amnaahmad43200/cloud-connected-aqi-network/docs/THESIS_FYP_REPORT[Final].pdf

CLOUD CONNECTED AQI NETWORK FOR PAKISTAN

by

Amna Ahmad

Zujaja Ibrahim

Supervisor

Faraan Mahmood

Department of Electrical Engineering

Institute of Space Technology, Islamabad

July 2024

i

CLOUD CONNECTED AQI NETWORK FOR PAKISTAN

by

Amna Ahmad

Zujaja Ibrahim

Supervisor

Faraan Mahmood

APPROVAL BY BOARD OF EXAMINERS

_____________________ | _____________________
Supervisor | Co-Supervisor
____________________ | _____________________
Internal Examiner | External Examiner

ii

AUTHORS DECLARATION

I take full responsibility of the research work conducted during the thesis titled

“Cloud Connected AQI Network for Pakistan”.

I solemnly declare that the research and development work presented in the thesis is

done solemnly by me with no significant help from any other person; however, small help

wherever taken is duly acknowledged. I have also written the thesis by myself. Moreover, I

have not presented this thesis or any part of the thesis previously to any other degree

awarding institution within Pakistan or abroad.

I understand that the management of IST has a zero-tolerance policy towards

plagiarism. Therefore, I as an author of the above-mentioned thesis solemnly declare that no

portion of my thesis has been plagiarized and any material used in this Thesis does not

contain any literal citing (verbatim) of more than 70 words (total) even by giving a reference

unless I have obtained the written permission of the publisher to do so. Furthermore, the

work presented in the thesis is my own original work and I have positively cited the related

work of the other researchers by clearly differentiating my work from their relevant work.

I further understand that if I am found guilty of any form of plagiarism in my thesis

work even after my graduation, the institute reserves the right to revoke my BS degree.

Moreover, the Institute will also have the right to publish my name on its website that keeps

a record of the students who plagiarized in their thesis work.

_____________________

Amna Ahmad

iii

Zujaja Ibrahim

I hereby acknowledge that submitted thesis is final version and should be scrutinized

for plagiarism as per IST policy

_____________________

Faraan Mahmood

Dated: _______________

________________________________

Verified by Plagiarism Cell Officer

Dated_______________

iv

CERTIFICATE

This is to certify that the research work described in this thesis is the original work of

the author and has been carried out under my direct supervision. I have personally gone

through all the data/results/materials reported in the manuscript and certify their

correctness/authenticity. I further certify that the material included in this thesis is not

plagiarized and has not been used in part or full in a manuscript already submitted or in the

process of submission in partial/complete fulfillment of the award of any other degree from

any institution. I also certify that the thesis has been prepared under my supervision

according to the prescribed format and I endorse its evaluation for the award of Bachelor of

Science in Electrical Engineering degree through the official procedures of the Institute.

____________________

Faraan Mahmood

v

### Copyright © 2022

This document is jointly copyrighted by the authors and the Institute of Space

Technology (IST). Both authors and IST can use, publish or reproduce this document in any

form. Under the copyright law no part of this document can be reproduced by anyone, except

copyright holders, without the permission of authors.

vi

DEDICATION

This research work is dedicated to our beloved Parents and Teachers and Friends who

supported and motivated us in tough times and made us into what we are today.

vii

ABSTRACT

The escalating concerns over air quality, particularly in urban areas like Islamabad,

necessitate effective remote monitoring and alert systems. This document details the

development of a prototype network for monitoring the Air Quality Index (AQI) in Islamabad.

The project employs strategically placed nodes with calibrated sensors, transmitting real-time

data to a central server through the MQTT protocol and sending hourly SMS alerts to the user

in case of the absence of a Wi-Fi connection. The data obtained through this network was used

in predictive analysis using machine learning algorithms, including Linear Regression, Cat-

Boost Regressor, Random Forest and Gradient Boost Regressor. A comparative analysis was

conducted to determine the best-fit model for accurate AQI predictions.

viii

### 1.1.1.1 TABLE OF CONTENTS

ix

x

xi

xii

xiii

LIST OF FIGURES

xiv

Figure 17: SSD1306 displaying individual pollutant concentrations and the Final AQI

xv

xvi

xvii

xviii

xix

LIST OF ABBREVIATIONS AND SYMBOLS

AQI

PPM

AWS

MQTT

PM

PCB

CO

IoT

Air Quality Index

Parts Per Million

Amazon Web Services

Message Queuing Telemetry Transfer

Particle Matter

Printed Circuit Board

Carbon mono-Oxide

Internet of Things

1

### 2 CHAPTER 01

### 2.1 Introduction

In recent years, the escalating concerns surrounding air quality have become a focal

point of concern. Urban areas face several challenges in maintaining breathable and sustainable

atmospheres. Islamabad, the capital city of Pakistan, is no exception to this predicament, with

its ever-growing population and rapid urbanization intensifying the need for effective air

quality management.

This paper delves into an initiative undertaken to address the critical issue of air quality

in Islamabad. The project centers around the establishment of a Network for Monitoring

Atmospheric Parameters and Air Quality Index (AQI). Such a network provides real-time data

that not only assesses the prevailing atmospheric conditions but also facilitates informed

decision-making for future development.

The network employs strategically placed nodes equipped with calibrated sensors,

which monitor key atmospheric parameters and AQI metrics. These sensors transmit real-time

data to a central server through the MQTT protocol, ensuring continuous monitoring and

analysis. In the event of a Wi-Fi connection failure, the system sends hourly SMS alerts to

users, maintaining a consistent flow of information.

Furthermore, the data collected by the network is utilized for predictive analysis using

a variety of machine learning algorithms, including Linear Regression, CatBoost Regressor,

Random Forest, and Gradient Boost Regressor. This approach enables the development of

predictive models that can forecast future air quality trends. A comparative analysis was

2

conducted to determine the most accurate and reliable model for AQI prediction, thereby

enhancing the system's capability to provide actionable insights.

To support this initiative, an AWS database was used for three months of data

collection, ensuring reliable and scalable storage of the vast amount of data generated. For

visualization of AQI parameters, the Blynk IoT platform was employed, providing an intuitive

and user-friendly interface for real-time monitoring and analysis of air quality metrics.

The initiative represents a significant step towards leveraging technology for

environmental sustainability and public health in Islamabad and then for Pakistan.

### 2.2 Problem Statement

Air quality degradation is a growing concern worldwide, particularly in rapidly

urbanizing cities like Islamabad, Pakistan. The city's increasing population and industrial

activities have led to significant air pollution, posing severe health risks to residents and

challenging the sustainability of the urban environment. Despite the critical need for effective

air quality management, there is a lack of real-time monitoring systems that can provide

accurate and actionable data on changing AQI levels.

Existing air quality monitoring solutions often suffer from absence of Real time data

monitors, lack of AQI data for accuracy comparison, and inadequate predictive capabilities,

hindering timely interventions and informed decision-making. Consequently, there is an urgent

need for a comprehensive, real-time monitoring network that can assess air quality accurately

and facilitate timely measures to reduce pollution. Without such a system, the ability to protect

public health and manage environmental quality in Islamabad remains severely compromised.

3

### 2.3 Objective

Due to rapid increase in pollution, Islamabad is in dire need of a proper air quality

monitoring network. Thus, the goal of this project is to cover the process of setting up a

prototype for an air quality monitoring network. By providing timely and accurate information,

this project not only addresses the immediate challenges of air quality but also lays the

groundwork for accurate and informed decision-making.

### 2.4 Literature Survey

To gain a comprehensive understanding of the current state and advancements in the

field of real-time air quality monitoring and predictive analysis, it is essential to review

related works. Numerous research studies and projects have been conducted over the past

few years, focusing on the development and implementation of air quality monitoring

systems. These studies highlight the importance of real-time data collection, data

preprocessing, and the application of machine learning models for accurate air quality

predictions.

In 2019, Rawal presented a research paper titled "Air Quality Monitoring System,"

which leverages sensor networks to collect real-time data on pollutants. The system

integrates gas sensors, such as MQ135 and MQ7, to measure critical pollutants like carbon

monoxide (CO), nitrogen dioxide (NO2), and particulate matter (PM). By continuously

monitoring these parameters, the system ensures accurate and timely information for

decision-makers and the public. Rawal’s work emphasizes the importance of data

preprocessing, which involves cleaning and transforming the raw sensor data to enhance its

quality and usability. Additionally, the study highlights the role of machine learning models

in predicting air quality trends. By applying algorithms to the preprocessed data, the system

4

can forecast future air quality levels, enabling timely measures to be taken to protect public

health. This research underscores the potential of integrating sensor networks and machine

learning for effective air quality management.

Another significant contribution to the field is the research paper by Banerjee, Sikdar,

and Roy, titled "IoT-based Air Pollution Monitoring." This study focuses on enhancing

environmental awareness through the deployment of a network of sensors across urban areas

to collect pollutant data. The data is then transmitted to a central server for analysis. The

project emphasizes several key aspects, including real-time monitoring, data visualization,

and public access. Continuous data collection from the deployed sensors ensures up-to-date

information on air quality. The collected data is visualized to provide clear and

comprehensible information to users, aiding in better understanding and awareness.

Furthermore, the system ensures that air quality information is accessible to the public,

promoting transparency and informed decision-making. By integrating IoT technologies,

Banerjee et al. contribute to sustainable urban development. Their work demonstrates how

real-time monitoring and data visualization can be leveraged to inform policy decisions and

engage the public in environmental protection efforts.

The Islamabad Air Quality Index (AQI) website by IQAir is another noteworthy

example of real-time air quality monitoring. This platform provides a comprehensive range

of features, including real-time data validation, pollutant concentrations, health

recommendations, forecasts, historical data, and opportunities for citizen participation. Key

features of the IQAir AQI website include real-time data validation, ensuring the accuracy

and reliability of the data presented to users; providing detailed information on the levels of

various pollutants in the air; offering advice on how to mitigate health risks associated with

poor air quality; predicting future air quality trends to enable timely actions; allowing users

5

to analyze past air quality patterns; and encouraging public involvement in monitoring and

reporting air quality issues. Leveraging these insights, the IQAir platform empowers users

with accurate information and contributes to a healthier environment. The integration of real-

time monitoring with user-friendly interfaces and actionable recommendations exemplifies

the potential of technology in addressing air quality challenges.

These studies and projects provide valuable insights into the development and

implementation of real-time air quality monitoring systems. By examining the methodologies

and findings of these works, we can identify best practices and potential areas for

improvement in our own project. The integration of sensor networks, data preprocessing,

machine learning models, and IoT technologies has proven to be effective in enhancing air

quality monitoring and predictive analysis.

6

### 3 CHAPTER 02

### 3.1 Solution Statement

Addressing the challenges highlighted in the problem statement, our solution focuses

on developing a robust Network for Monitoring Atmospheric Parameters and Air Quality

Index (AQI) in Islamabad. This initiative aims to establish a comprehensive real-time

monitoring system that effectively assesses and manages air quality in urban environments.

The solution involves deploying strategically placed sensor nodes equipped with

calibrated sensors to measure key atmospheric parameters and pollutants such as carbon

monoxide (CO), nitrogen dioxide (NO2), particulate matter (PM), and others. These sensors

will continuously collect real-time data and the esp32 microcontroller will process the AQI

using the set international standards and a Rolling Average of 24 values which were hourly

collected throughout the day is implemented in the final AQI calculation. The AQI along

with the individual concentration of the pollutants is transmitted to a central server using the

MQTT protocol. In case of Wi-Fi connection failure, the system will still send hourly SMS

alerts to users, ensuring uninterrupted monitoring and timely responsiveness.

To enhance the domain and usability of our cloud connected AQI network, our

solution incorporates robust data preprocessing techniques and Time Series predictive

analysis. This includes cleaning and transforming raw sensor data to eliminate noise and

improve data quality. Machine learning algorithms, including Linear Regression, CatBoost

Regressor, Random Forest, and Gradient Boost Regressor, will be employed for predictive

analysis. This analytical approach enables the development of models capable of forecasting

7

future air quality trends, thereby facilitating proactive measures to reduce pollution and

protect public health.

Furthermore, to optimize energy usage and extend operational longevity, each sensor

node's battery is optimized. The ESP32 microcontroller, utilized in each node, enters sleep

mode after every hourly reading over a 24-hour period while it’s RTC memory keeps a

record of previous data. This power-saving strategy ensures that approximately 97.5% of the

battery life is conserved, enhancing sustainability and reducing operational costs.

The solution also leverages advanced data storage capabilities, utilizing an AWS

database for three months of data collection. For visualization and user interface, the Blynk

IoT platform is utilized, providing intuitive access to real-time AQI parameters and historical

trends. This user-friendly interface empowers stakeholders with actionable insights,

promoting informed decision-making and community engagement in environmental

management.

By integrating these components into a cohesive network, our solution aims to

contribute to sustainable urban development and improve air quality management practices

in Islamabad.

### 3.2 Individual Description of Equipment used in each node

### 3.2.1 ESP32

The ESP32 microcontroller was chosen for its flexibility and efficiency in IoT

applications. Its dual-core architecture, low power consumption, and built-in Wi-Fi

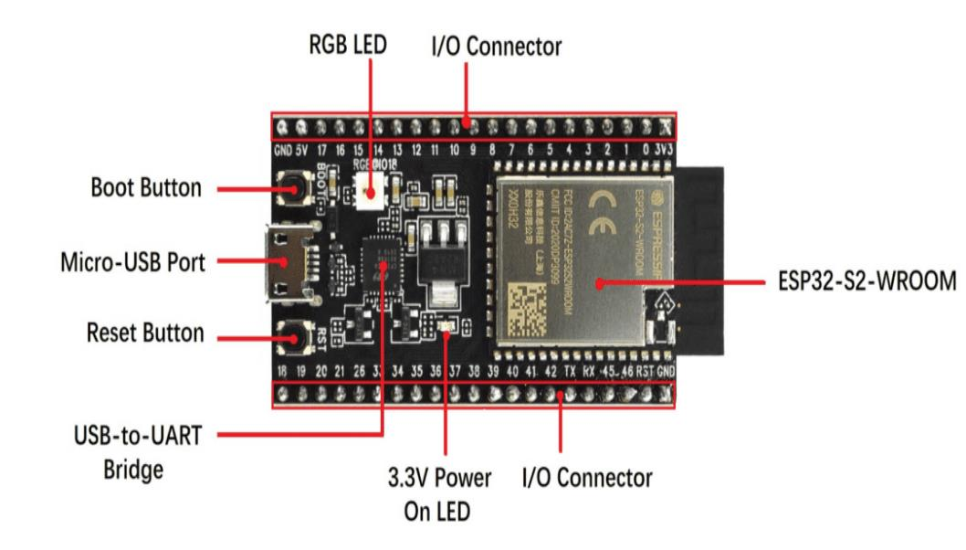
[picture p13: figure]

8

capabilities make it ideal for collecting, processing, and transmitting real-time air quality

data. Additionally, the ESP32's ability to enter sleep mode between hourly readings

maximizes battery life, crucial for prolonged field deployments without compromising data

reliability or operational lifespan.

Figure 1: ESP32 micro-controller

### 3.2.2 MQ7

The MQ7 sensor is commonly used for detecting carbon monoxide (CO) gas in the

atmosphere. It operates based on the principle of chemical reaction with CO, generating an

electrical signal proportional to the gas concentration. This sensor is valued for its sensitivity

and reliability in monitoring CO levels, making it suitable for applications in air quality

monitoring and safety systems.

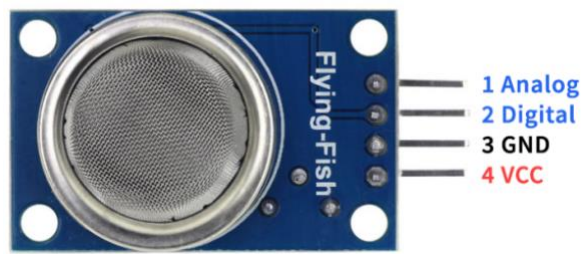
[picture p14: figure]
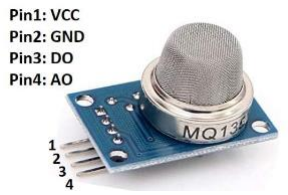
[picture p15: figure]

9

Figure 2: MQ7 Sensor pinout

### 3.2.3 MQ135

The MQ135 sensor detects sulfur dioxide (SO2) by utilizing a chemical reaction

mechanism. It operates by exposing a tin dioxide (SnO2) sensing element to the air

containing SO2. When SO2 molecules come into contact with the SnO2 surface, they

undergo a chemical reaction, changing the electrical conductivity of the sensor. This change

in conductivity is then converted into an electrical signal, which is proportional to the

concentration of SO2 in the air.

Due to its sensitivity to SO2, the MQ135 sensor is commonly used in environmental

monitoring applications, and indoor air quality assessments where monitoring SO2 levels is

critical for health and safety reasons.

Figure 3: MQ135 sensor pinout

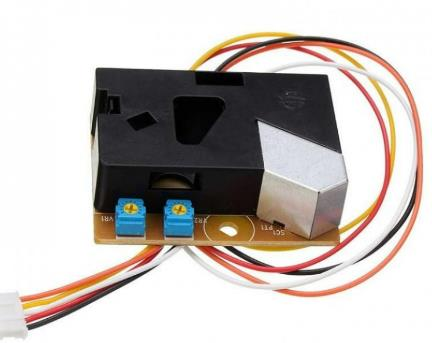
[picture p16: figure]

10

### 3.2.4 DSM501A

The DSM501A sensor is used for detecting fine particulate matter (PM2.5 and PM10)

in the air. It operates based on a principle involving light scattering by particles passing

through an LED and photodetector pair. As particles pass through the sensor, they scatter

light, and the intensity of scattered light detected by the photodetector correlates with the

concentration of particulate matter in the air.

This sensor is valued for its accuracy in measuring PM2.5 and PM10 levels, making

it suitable for applications in air quality monitoring systems, indoor air quality assessments,

and environmental monitoring. Its ability to provide real-time data on particulate pollution

helps in assessing health risks associated with fine particulate matter exposure.

Figure 4: DSM501A image

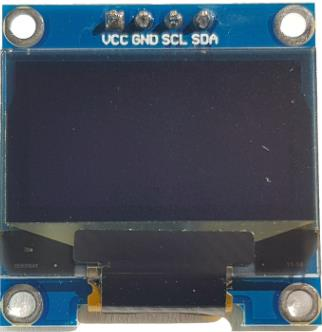
[picture p17: figure]

11

### 3.2.5 OLED

The following two types of OLEDs were utilized in this project to show the

versatility of display on hardware.

### 3.2.5.1 SSD1306 128x64

The SSD1306 128x32 OLED display is a small screen known for its clear and bright

display. It uses organic light-emitting diodes to show sharp text and graphics without needing

a backlight, making it great for small devices and projects where space and power are limited

which is the case in this prototype. It typically interfaces with microcontrollers using the I2C

communication protocol, allowing for easy and efficient data transfer.

Figure 5: SSD1306 image

### 3.2.5.2 TFT 128x160

The TFT 128x160 display is a thin-film transistor screen that offers bright colors and

high resolution. It provides clear and detailed images, making it suitable for applications that

need vibrant display (Creative and enlarged display of AQI). This display usually interfaces

with microcontrollers using the SPI communication protocol, ensuring fast and reliable data

communication.

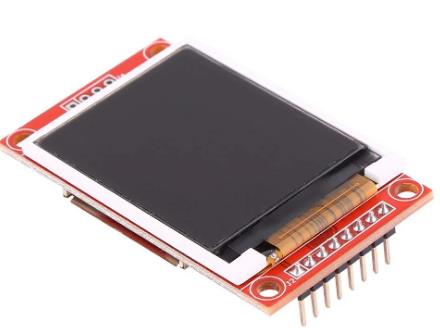
[picture p18: figure]
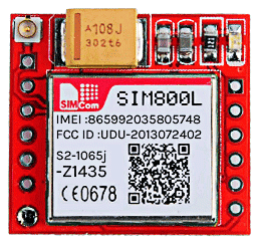
[picture p19: figure]

12

Figure 6: TFT 128X64 image

### 3.2.6 SIM800L

The SIM800L module is a compact GSM/GPRS module used for wireless

communication. It enables devices to send SMS alerts and make voice calls over the GSM

2G network. In this project, the SIM800L is utilized to send hourly SMS alerts so the user

stays aware of the AQI even when there is no Wi-Fi, ensuring continuous monitoring and

timely notifications. Its small size, low power consumption, and reliable connectivity make it

ideal for remote monitoring applications.

Figure 7: SIM800L image

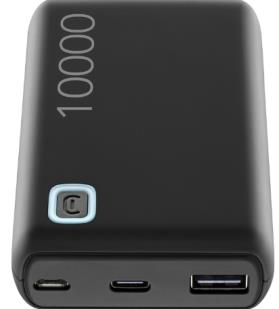
[picture p20: figure]

13

### 3.2.7 Power Source

A 5V 2A power bank is used to power the AQI node, providing a reliable and

portable power source. The power bank's 5V output is compatible with the node's

requirements, and its 2A current rating ensures stable and adequate power for all connected

components, enhancing the system's overall reliability and mobility.

Figure 8: 5V 2A Power bank

### 3.2.8 Micro USB cable

The cable is used to encode the esp32 and to connects the power bank to it, ensuring a

steady and reliable power supply. The cable supports the power needed by the AQI node,

helping to keep the system running smoothly and reliably in different settings.

Figure 9: Micro USB cable

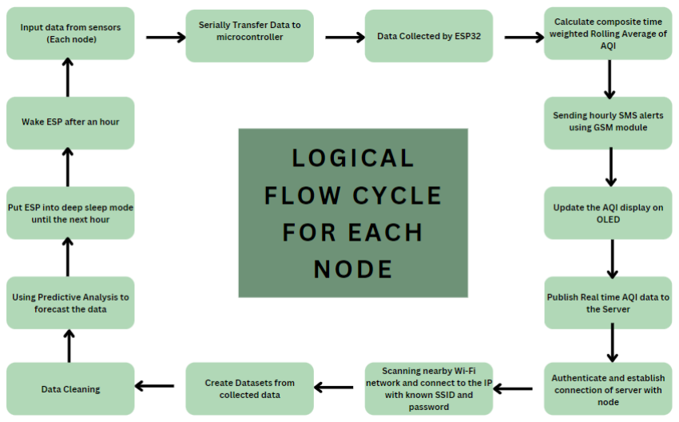
[picture p21: figure]

14

### 3.3 Block Diagram

The following flow diagram illustrates the logical working of a single node. The

block Diagram looks like a cycle which repeats because ESP32 repeats this process every

time after it wakes up from its deep sleep mode.

Figure 10: Block Diagram Illustration

15

### 4 CHAPTER 3: SYSTEM DETAILS

The individual node is comprised of the necessary sensors connected to the ESP32

microcontroller to measure the concentrations of the air pollutants in the air that are then

inserted into the formula for AQI which is then messaged to the user, displayed on node’s

OLED and uploaded on the cloud server Blynk in real time. The data collected was the stored

and further used for Predictive analysis using different machine learning models. This block

of the report will go into details about each process mentioned above

### 4.1 Sensors and their calibration:

The sensors attached to each node included 3 sensors which are connected to the ESP 32:

i. MQ 7: Measures the concentration of Carbon monoxide
ii. | MQ135: Measures the concentration of Sulfites
iii. | DSM501A: Measures the concentration of PM2.5 and PM1

### 4.1.1 Calibrating MQ-7:

The internal sensor resistance (RS) is calculated using the formula:

where VC is the circuit voltage, RL is the load resistance, and VRL is the voltage across

the load resistor.

RS = (

VC−VRL
VRL
)−RL | (1)

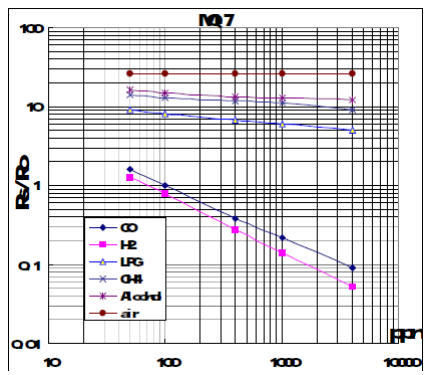
[picture p22: figure]

16

Figure 11: Sensitivity characteristics of MQ7

From the graph, the resistance ratio (RS/R0) in fresh air is observed to be a constant

value of 20.8. To find the reference resistance (R0), measure RS in clean air and use

the ratio:

Measure the analog voltage readings from the sensor. Convert these readings to

voltage values to determine RS using the formula provided. The graph (Fig. 3.1)

shows RS/R0 versus ppm for different gases. To calculate gas concentration, read the

graph whilst using a log-log scale.

The relationship is linearized using the formula:

RS/RO = 20.8 | (2)

log (

RS
RO) = m ∗ log(x) + b
(3)

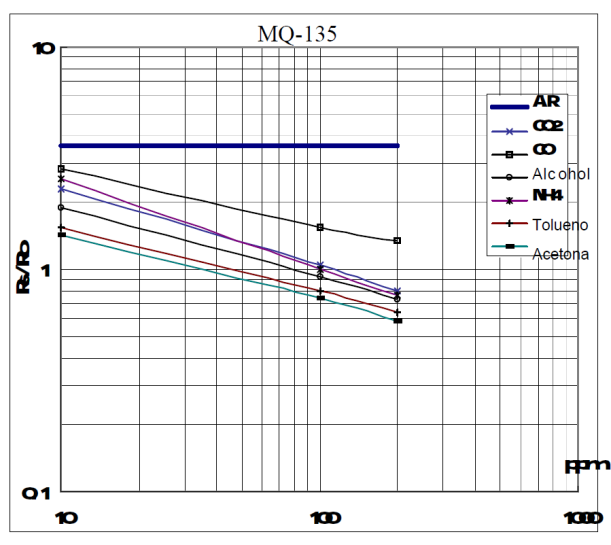
[picture p23: figure]

17

### 4.1.2 Calibrating MQ-135

The process of calibration for MQ135 follows the same steps as that for MQ7 with the

exception of the values from the sensitivity curve. Which is as follows:

Figure 12: Sensitivity characteristics of MQ135

### 4.1.3 Calibrating DSM501A

To take readings from the DSM501A sensor firstly we calculated the low ratio by

measuring the sum of low pulses received to the GPIO pins of the ESP32 for 30 seconds. The

value was then inserted into the equation provided to us in the sensor’s datasheet which is as

follows:

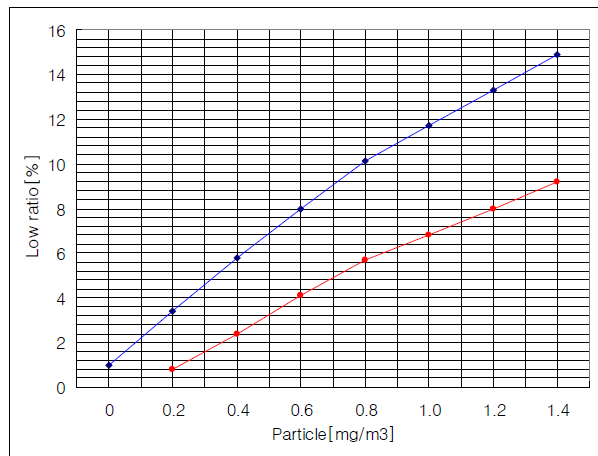
[picture p24: figure]

18

The calculated low ratio is then mapped across the sensor characteristic vs low ratio graph provided in the datasheet which is shown below:

Figure 13: Sensor characteristic vs Low ratio

Using the calculated low ratio percentage and the graphs we deduced the values of PM2.5

and PM1 in mg/m3 dividing each concentration by 1000 we converted our units to ug/m3

### 4.2 Calculating time weighted AQI

The pollutants used to calculate the AQI included CO, SO2, PM2.5 and PM1 Each

pollutant has specific concentration ranges, known as breakpoints, associated with

corresponding AQI value ranges that indicate different levels of health concern. To calculate

Low ratio[%] =

t(sec)
30(sec)
∗ 100 | (1)

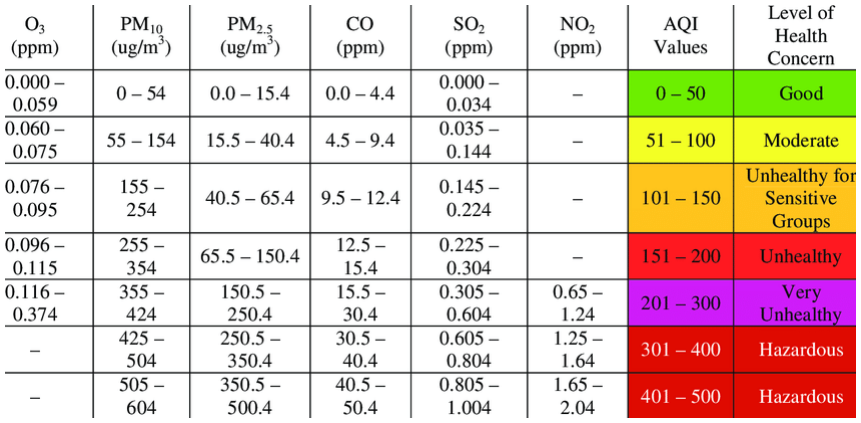
[picture p25: figure]

19

the AQI, the concentration of each pollutant is measured and its corresponding breakpoint

range is identified. A linear equation is then used to calculate the AQI for each pollutant:

where IH and IL are the AQI values at the upper and lower ends of the breakpoint

range, and CH and CL are the concentration breakpoints at the upper and lower ends of the

range, with C being the measured concentration. The breakpoint values are set using the

standard EPA’S breakpoint table for each pollutant.[2] (https://www.researchgate.net/figure/EPAs-breakpoint-and-AQI-Index_tbl1_315006128)

Figure 14: EPA's breakpoint and AQI Index [2]

In the process of calculating the composite time-weighted rolling average for AQI,

weights are assigned to data points of each pollutant based on their age, with recent data

points receiving higher weights through an exponential decay factor of 0.5. Subsequently, the

time-weighted rolling average for each pollutant is computed by multiplying each AQI data

AQI= (IH−IL)/(CH−CL)) ×(C−CL) +IL | (1)

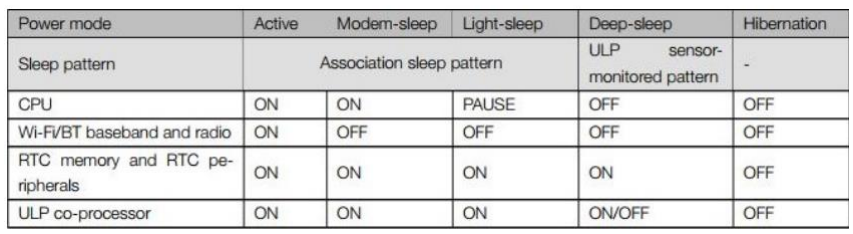
[picture p26: figure]

20

point by its respective time-based weight, summing these products, and then dividing by the

sum of the weights. Following this, composite weights are determined for each pollutant

based on their health impact and regulatory significance, representing their relative

importance in the overall air quality index. These composite weights are then used to

calculate the weighted rolling average for each pollutant. Finally, the weighted rolling

averages of all pollutants are summed to obtain the composite time-weighted rolling average

AQI, providing a unified measure that integrates the effects of all included pollutants and

reflects the overall air quality.[1] (https://forum.airnowtech.org/t/the-nowcast-for-pm2-5-and-pm10/172)

### 4.3 Using deep sleep mode of ESP32:

When our node wasn't sampling pollutant values, calculating AQI, or sending data to the

cloud server, it would enter sleep mode to conserve energy. This energy-saving feature is

crucial for extending the battery life of the device, especially in remote or off-grid locations.

Figure 15: Sleep Mode comparison chart [3]

The Real-Time Clock (RTC) of the microcontroller played a vital role by triggering the

ESP32 from sleep mode to active mode at scheduled intervals. Upon waking, the ESP32

would sample sensor values for various pollutants and store them in a circular queue. Circular

queues were chosen because they efficiently manage a fixed-size buffer, making them ideal

21

for continuously updating datasets like pollutant levels over time. A total of five circular

queues were created: one for SO₂ values, one for CO, one for PM2.5, one for PM1, and one

for AQI. These circular queues were stored in the RTC memory of the ESP32, which is non-

volatile, ensuring that all past 24-hour values were retained even when the controller was in

sleep mode. This setup allows for continuous monitoring and accurate calculation of AQI by

maintaining a rolling history of pollutant concentrations, ensuring data integrity and

reliability.

### 4.4 OLED display

An OLED display is attached to the node's casing to show the values of PM1 and PM2.5 in

µg/m³, SO₂ and CO in ppm, and the final calculated AQI every hour when the ESP32 is

triggered from sleep to active mode. This real-time display allows users to quickly and easily

monitor air quality data. We evaluated two display options: the SSD1306 and the TFT

128x160. The TFT 128x160 offered a larger and more vibrant display, enhancing readability

and providing more space for detailed information. However, it consumed significantly more

energy, which was a drawback for our battery-operated nodes designed for extended field

deployment. As a result, we opted for the SSD1306 for most of our nodes due to its lower

power consumption, compact size, and sufficient resolution for displaying all necessary

information clearly. This choice effectively balanced the need for energy efficiency with the

requirement for a functional and user-friendly interface.

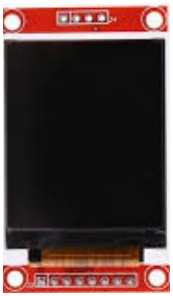
[picture p27: figure]
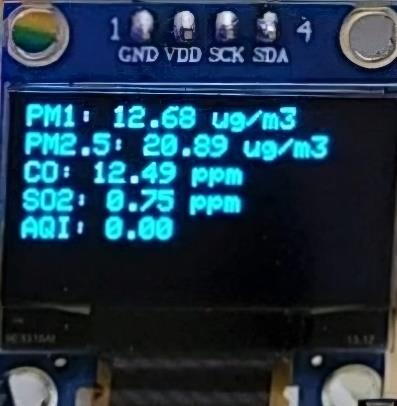
[picture p28: figure]

22

Figure 16: TFT display

Figure 17: SSD1306 displaying individual pollutant concentrations and the Final AQI

### 4.5 Sending SMS alerts to users

Using the GSM SIM800L module, we sent hourly updates to our users about air

pollutant concentrations. These updates included the values of PM1 and PM2.5 in µg/m³,

SO₂ and CO in ppm, and the calculated AQI. The ESP32 would wake from sleep mode every

hour to collect the latest data and transmit it in real-time, ensuring users received up-to-date

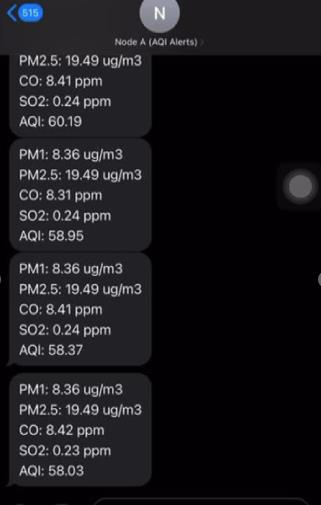
[picture p29: figure]

23

information about air quality at the specific geolocation where the node was placed. This

system provided users with critical information to help them make informed decisions about

their environment. The SIM800L module was chosen for its reliable GSM connectivity and

low power consumption, making it suitable for our remote monitoring needs. Only selected

phone numbers that were pre-programmed into the code would receive these notifications,

ensuring that the updates were sent exclusively to authorized users. This selective

notification system enhanced security and ensured that the information reached the right

recipients without unnecessary data transmission.

Figure 18: SMS Alerts received on user's phone

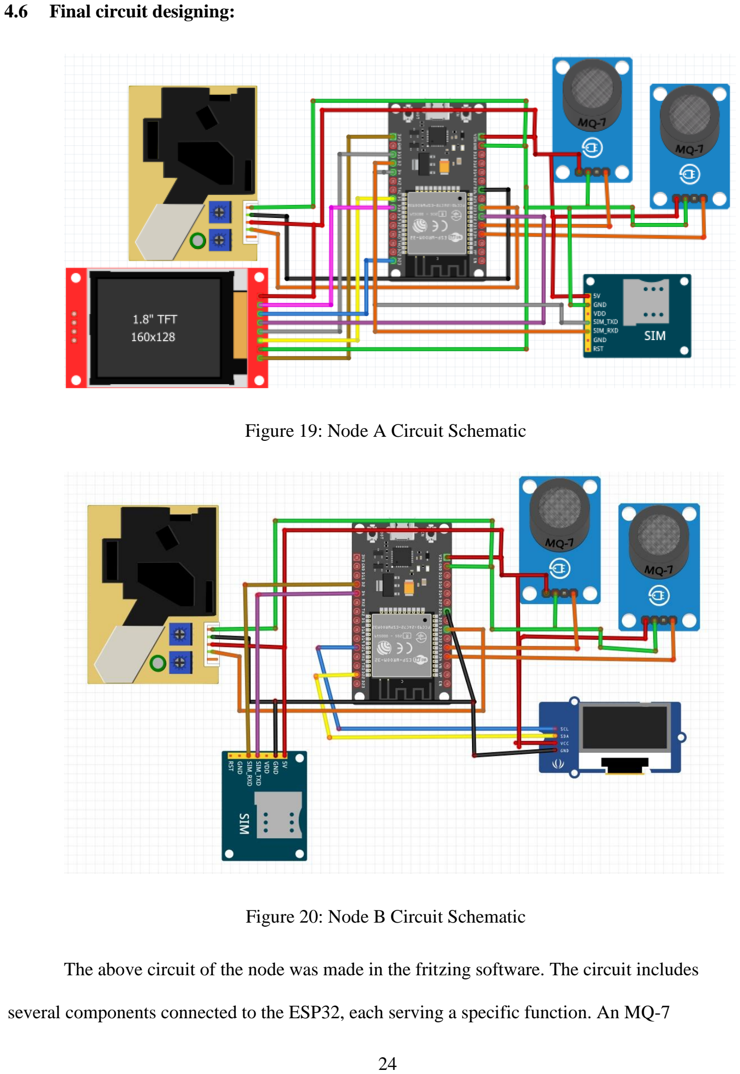
[picture p30: page 44]

24

### 4.6 Final circuit designing:

Figure 19: Node A Circuit Schematic

Figure 20: Node B Circuit Schematic

The above circuit of the node was made in the fritzing software. The circuit includes

several components connected to the ESP32, each serving a specific function. An MQ-7

25

sensor is used for measuring carbon monoxide (CO) levels, and an MQ-135 sensor is used

for measuring sulfur dioxide (SO₂) levels. A DSM501A sensor is included to measure

particulate matter levels (PM2.5 and PM1). The SIM800L GSM module is integrated to send

hourly air quality updates via SMS to pre-programmed phone numbers. Additionally, a 1.8"

TFT 160x128 display is used for real-time visualization of pollutant concentrations and AQI.

The wiring diagram shows the connections between these components and the ESP32.

The red wires represent connections to the 5V supply of the ESP32, while the green wires

represent ground connections.

### 4.7 PCB designing:

Firstly, the design of our air quality monitoring node’s schematic was designed using

Proteus software. schematic diagram detailed the connections between the ESP32

microcontroller, MQ-7 sensors for CO detection, MQ-135 sensor for SO₂ detection,

DSM501A sensor for PM2.5 and PM1 detection, and the SIM800L GSM module for SMS

notifications. Female headers were used to place the sensors, OLED and sim module on top

of them to form stable connections with the ESP32 board.

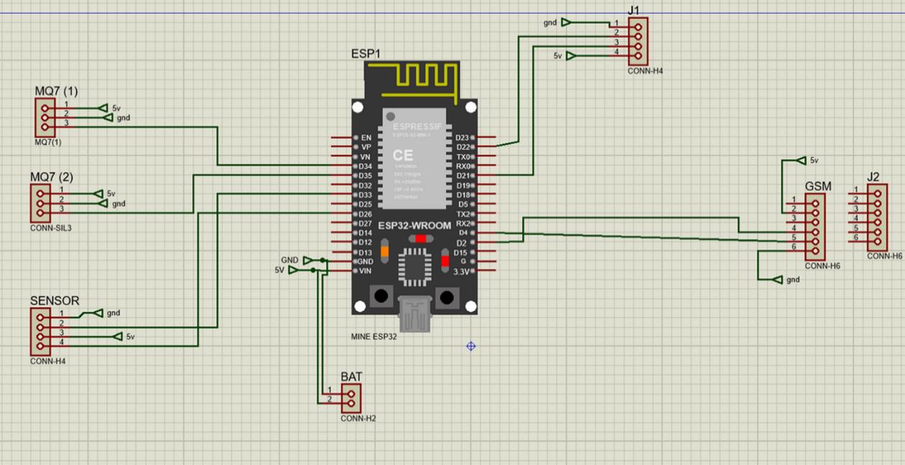
[picture p31: figure]

26

Figure 21: Circuit Design of node in proteus

Secondly, the PCB layout was generated in Proteus, highlighting the routing

connections to ensure no interference between unwanted connections. The PCB design

composes the components onto a compact board, facilitating easy assembly and deployment

of the monitoring node.

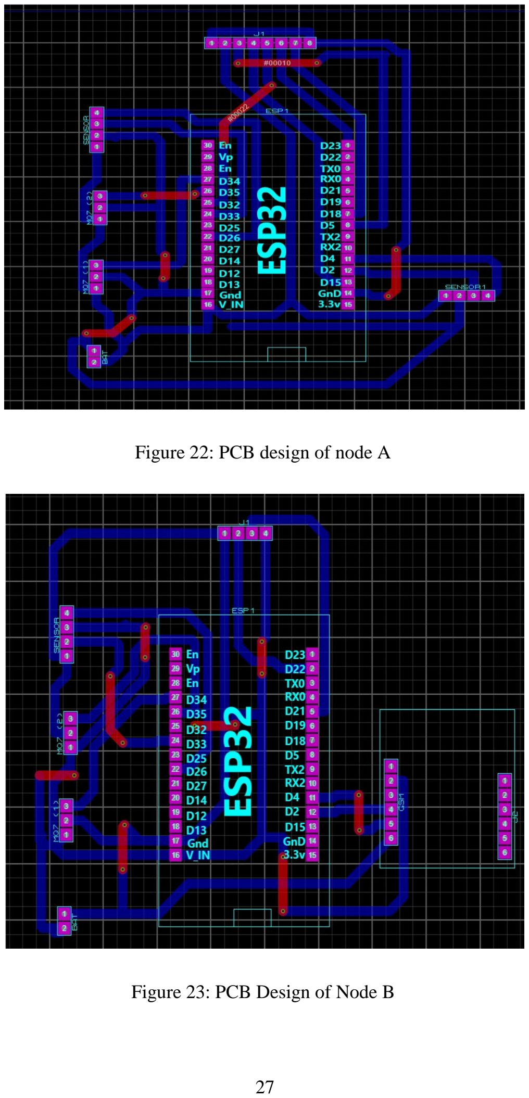
[picture p32: page 47]

27

Figure 22: PCB design of node A

Figure 23: PCB Design of Node B

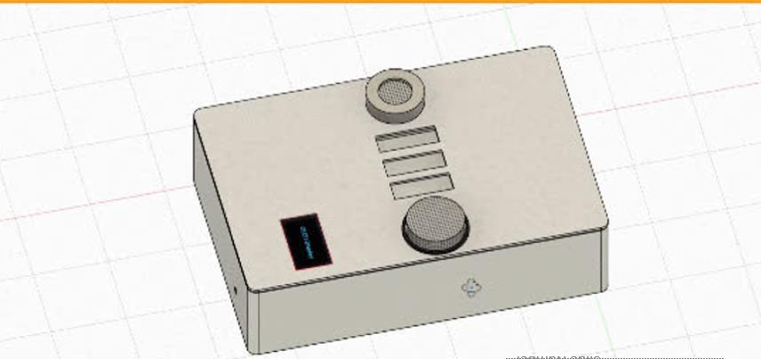
[picture p33: figure]

28

### 4.8 CAD 3D Casing designing:

We further designed a protective casing using Fusion 360 software. This custom

casing was meticulously crafted to house the circuit and sensors securely, ensuring durability

and protection from external elements. Specific slots were created within the casing to

accommodate the sensors and the OLED display, allowing them to function optimally while

remaining protected. After finalizing the design, we fabricated the casing and installed the

circuit and sensors into their respective slots. This integration ensured that the air quality

monitoring node was ready for deployment in various environmental conditions.

Figure 24: 3D Model of Node Casing

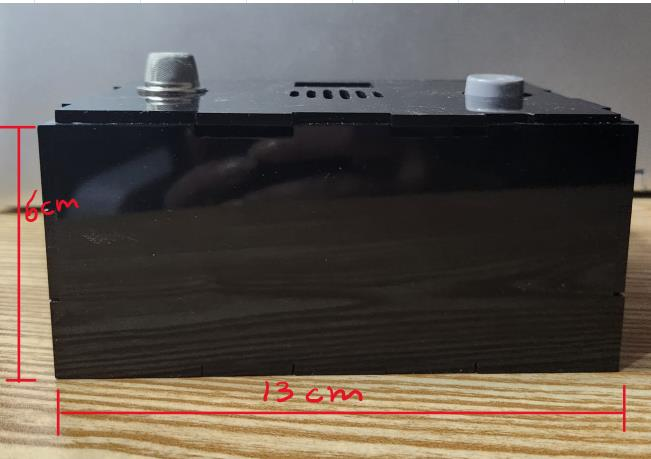
[picture p34: figure]
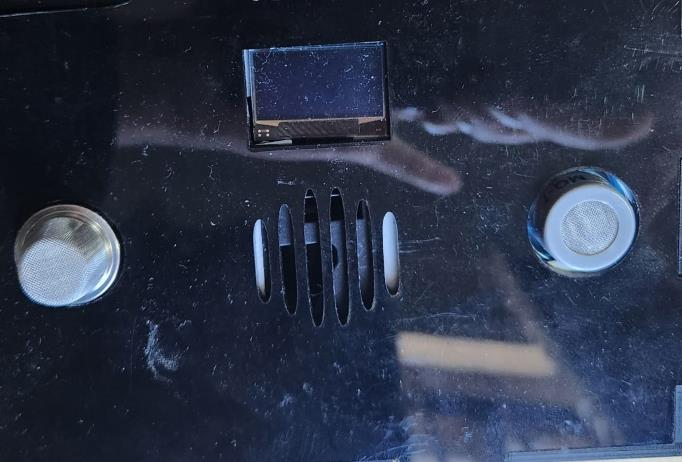
[picture p35: figure]

29

Figure 25: Side View and dimensions of Node's casing

Figure 26: Top View of Node Casing

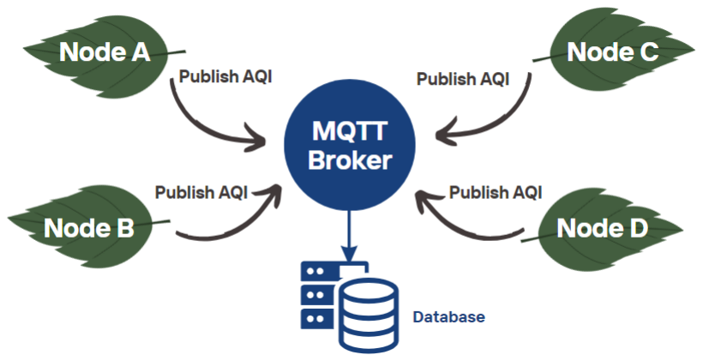
[picture p36: figure]
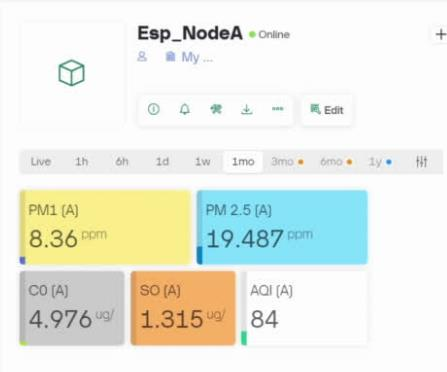
[picture p37: figure]

30

### 4.9 Cloud Setup

As this project revolves around cloud connected AQI network, each node is created to

publish individual pollutant concentrations and final AQI to a cloud platform using the

Message Queuing Telemetry Transfer (MQTT) protocol.

Figure 27: Cloud Network Structure

The cloud platform used for data collection was AWS IoT Core, while Blynk IoT

Cloud was employed for data visualization.

Figure 28: Data Visualization on Cloud

31

The data reception process begins with the ESP32 connecting to a specified Wi-Fi

network using the pre-defined SSID and password. Essential cloud authentications, including

certificates, Template ID, Device ID, and Authorization Token, are used to securely connect

to the project's cloud platform. The MQTT protocol's topic definition establishes a known

path for the nodes and central broker to publish data in JSON format. Once published, the

data is stored in the cloud database. The dataset, obtained in CSV format, is then used for

further data processing.

### 4.10 Dataset:

We placed our node at a specific geolocation in Islamabad and followed the described

process to collect hourly values of SO₂, CO, PM1, PM2.5 and AQI. This data collection took

place from March 10 to June 30, resulting in approximately 2,717 values for each parameter,

recorded at one-hour intervals. During this period, the ESP32 would wake from sleep mode

every hour to sample the sensors, calculate the AQI, store the data, send updates via the

GSM SIM800L module and upload data to cloud server in real time. This approach provided

us with a dataset for analyzing air quality trends over nearly 3 months, allowing us to gather

insights into pollution patterns in Islamabad.

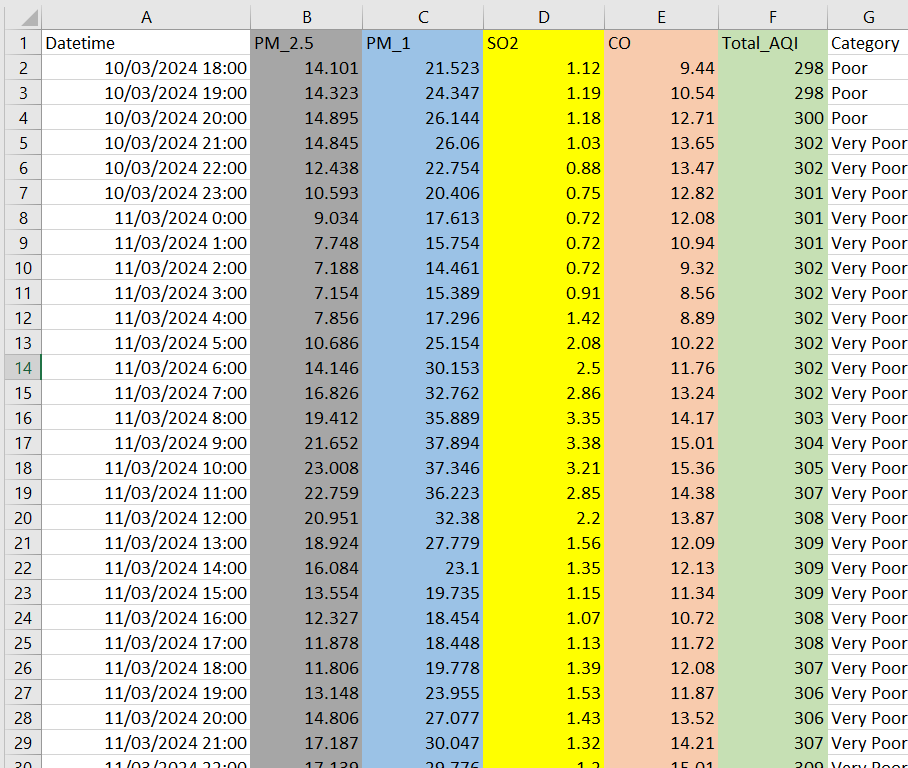
[picture p38: figure]

32

Figure 29: Collected Dataset in CSV format

### 4.11 Process for predictive analysis:

After collecting our dataset, we took 9 steps to perform predictive analysis on our

data.

1. Data visualization
2. Parameter correlation with AQI
3. Data splitting
4. Training Linear Regression model
5. Training Random Forest model

33

6. Training Gradient Boosting model
7. Training CatBoost Regressor model
8. Model evaluation test comparison

### 4.11.1 Data Visualization:

After collecting the relevant dataset, we performed data visualization by importing

the data from an Excel file and displaying it in various visual formats. Graphs and charts

were created to represent the trends and patterns of the air pollutant concentrations and AQI

over time, making it easier to understand the data at a glance.

### 4.11.2 Parameter correlation with AQI:

We then conducted a correlation analysis to determine the relationship between the

different parameters (SO₂, CO, PM1, and PM2.5) and the AQI. By calculating correlation

coefficients and displaying them in a heatmap, we confirmed positive correlations between

the pollutant concentrations and AQI, indicating that as pollutant levels increased, so did the

AQI.

### 4.11.3 Training Linear Regression model:

For predictive analysis, we first used linear regression, a straightforward method that

models the relationship between a dependent variable (AQI) and one or more independent

variables (pollutant concentrations). This model provided a baseline for understanding how

each parameter individually impacted AQI.

### 4.11.4 Training Random Forest model:

Next, we applied the Random Forest algorithm, which is an ensemble learning method

that constructs multiple decision trees during training and outputs the mean prediction of

34

the individual trees. This method is effective for capturing complex interactions between

parameters and improving prediction accuracy.

### 4.11.5 Training Gradient boosting model:

We also employed Gradient Boosting, which builds an ensemble of trees

sequentially, where each tree attempts to correct the errors of the previous one. This

approach focuses on minimizing prediction errors and enhancing the model's performance

through iterative improvement.

### 4.11.6 Training CatRegressor model:

CatBoost Regressor, a gradient boosting algorithm developed specifically for

categorical features, was also utilized. This model is known for its fast-training process and

high prediction accuracy, making it suitable for handling the structured dataset of air quality

parameters and AQI.

### 4.11.7 Model Evaluation Tests:

We later used a series of tests, as outlined in the table, to compare the performance of the predictive models. The tests included:

4.11.7.1 Training Time:

This measures the duration it takes for each model to learn from the training data. It is

crucial for evaluating the efficiency of the models, especially when dealing with large

datasets

4.11.7.2 Training Score:

This reflects how well the model fits the training data, providing an initial indication

of the model's capability.

35

4.11.7.3 Test Score:

This evaluates the model's performance on the testing data, helping to assess its

generalizability and predictive power.

4.11.7.4 R2 Score:

This metric indicates how well the predicted values match the actual values, with

higher scores representing better performance.

4.11.7.5 RMSE (Root Mean Square):

This measures the average magnitude of the errors between predicted and actual

values, with lower values indicating higher accuracy

4.11.7.6 MAPE (Mean Absolute Percentage Error):

This calculates the percentage error between predicted and actual values, providing a

normalized measure of prediction accuracy.

These tests enabled us to compare the models comprehensively, identifying the most accurate and efficient model for predicting air quality based on the collected data.

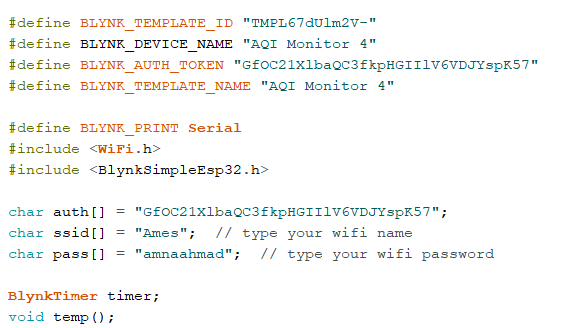
[picture p39: figure]

36

### 5 CHAPTER 4: CODE EXPLANTIONS

### 5.1 C programming on ESP32

ESP 32 was programmed using the Arduino IDE in C language to interface with the

sensors, GSM module, OLED and establishing Cloud connecting using its Wi-Fi module.

The code contains various in built and user defined function for structured execution and

improved readability. All functions are called in void setup() and user defined functions,

GPIO pins, Wi-Fi authentication credentials, necessary library headers and module

definitions are declared outside of it.

### 5.1.1 Wi-Fi declarations and credentials

This section of the code sets up and configures the Blynk platform and WiFi for an

ESP32-based air quality monitor. It defines the Blynk credentials (template ID, device name,

auth token, and template name) and includes necessary libraries (`<WiFi.h>` and

`<BlynkSimpleEsp32.h>`). Wi-Fi credentials (auth token, SSID, and password) are stored in

arrays. A `BlynkTimer` object is initialized for scheduling tasks, and the `temp` function is

declared for temperature-related operations.

Figure 30: Wi-Fi Declarations

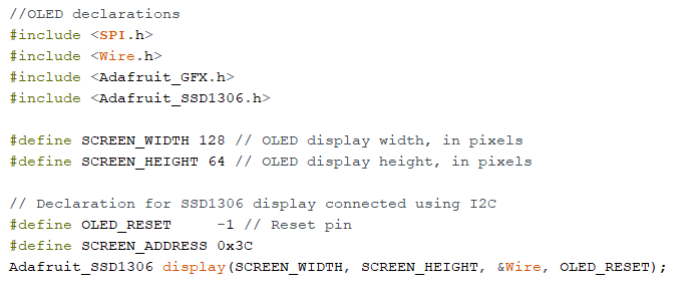
[picture p40: figure]

37

### 5.1.2 Global Variables

These Global variables are defined to store values which are to be sent to the cloud

and have to be used globally throughout the cloud.

Figure 31: Global variables for Cloud data transfer and storage

### 5.1.3 OLED declarations

This code sets up the OLED display for an ESP32 project. It includes the necessary

libraries and defines the display's width (128 pixels) and height (64 pixels). The reset pin is

defined as `OLED_RESET` with a value of -1, indicating it is not used, and the I2C address

is set to `0x3C`. An `Adafruit_SSD1306` object named `display` is created with these

parameters.

Figure 32: OLED declarations

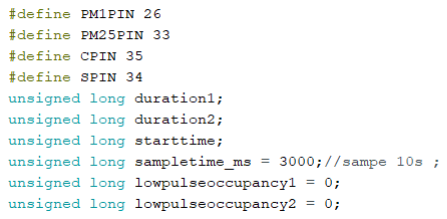
[picture p41: figure]

38

### 5.1.4 Sleep Mode Declarations

This code configures the ESP32 for deep sleep mode. It defines a conversion factor

(`uS_TO_S_FACTOR`) to convert microseconds to seconds and sets the sleep duration

(`TIME_TO_SLEEP`) to 3 seconds. The variables `bootCount` and `runcount` are declared

with the `RTC_DATA_ATTR` attribute, allowing them to retain their values during deep

sleep cycles.

Figure 33: Sleep Mode declarations

### 5.1.5 GPIO pin definitions and necessary variables’ initialization

This part of the code declares various variables and pin definitions. The `#define`

statements assign pin numbers for PM1, PM2.5, CO, and SO sensors. The `unsigned long`

and `float` variables are used for timing, sensor data, and calculations related to air quality

indices (AQI). The `composite weightage` variables hold weights for different pollutants in

the AQI calculation.

Figure 34: GPIO pins and variables declaration (part 1)

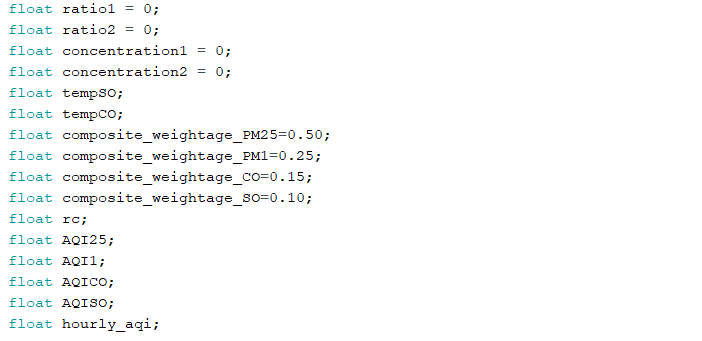
[picture p42: figure]

39

Figure 35: GPIO pins and variable declaration (part 2)

### 5.1.6 Individual pollutant concentration functions’ declaration

This part of the code deals with the declaration of all individual pollutant

concentrations’ calculator functions.

Figure 36: Individual Pollutant concentration functions' declaration

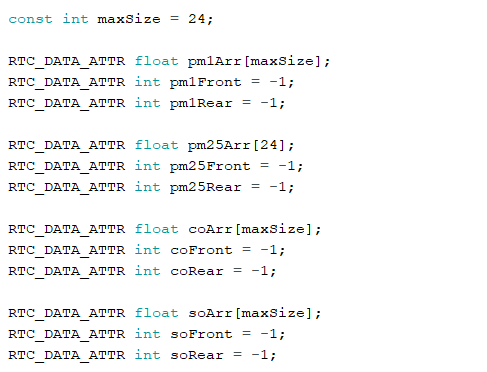
[picture p43: figure]

40

### 5.1.7 RTC data array for 24 values

This part of the code defines circular buffers for storing air quality data over time for

PM1, PM2.5, CO, and SO concentrations. Each buffer can hold up to ‘maxSize’ (24)

readings which are the hourly values throughout the day. The ‘RTC_DATA_ATTR’ attribute

ensures these variables retain their values during deep sleep mode of the ESP32. Arrays

‘pm1Arr’, ‘pm25Arr’, ‘coArr’, and ‘soArr’ store the readings, while ‘pm1Front’, ‘pm1Rear’,

‘pm25Front’, ‘pm25Rear’, ‘coFront’, ‘coRear’, ‘soFront’, and ‘soRear’ keep track of the

front and rear indices for each buffer, initialized to -1 indicating they are empty.

Figure 37: RTC data array for 24 values

### 5.1.8 Circular Queue Functions

The `Queue_enqueue` function manages the insertion of values into a circular queue

implemented using an array `arr`. When the queue is empty, it initializes both `front` and

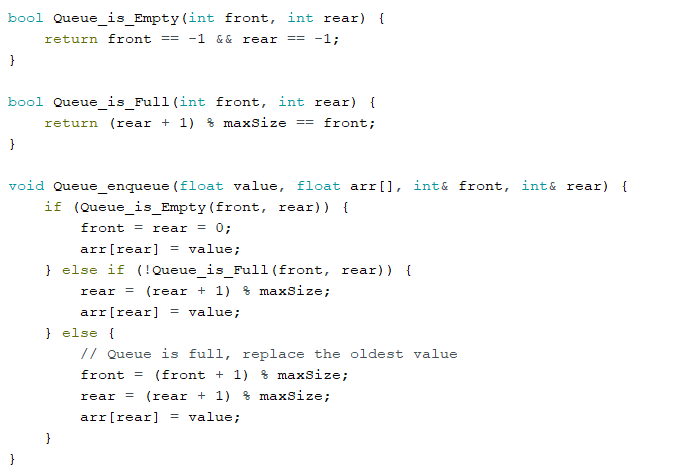
[picture p44: figure]

41

`rear` to 0 and inserts the `value` at `rear`. If the queue is not full, it increments `rear` to the

next position in the circular array and inserts the `value` there. When the queue is full, it

replaces the oldest value by incrementing `front` to skip over the oldest element and adjusts

`rear` to insert the `value` in the next available slot, effectively implementing a circular

buffer. This approach ensures efficient handling of both empty and full states of the queue

while maintaining the integrity of its circular structure.

Figure 38: Queuing Function definition

The ‘Queue_display’ function checks if the circular queue, stored in array ‘arr’

between `front` and `rear`, is empty using “Queue_is_Empty”. If empty, it prints "Queue is

empty!". Otherwise, it initializes ‘i’ from `front` and iterates through the queue with a do-

while loop, printing each element at `arr[i]`. Index ‘i’ wraps around using modulo arithmetic

‘(i + 1) % maxSize’ until it reaches ‘(rear + 1) % maxSize’, ensuring all elements are

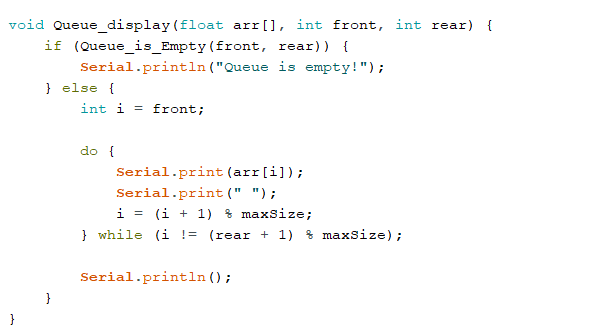
[picture p45: figure]

42

displayed. This function efficiently displays the circular queue's contents on Arduino’s serial

monitor.

Figure 39: Queuing display function

### 5.1.9 OLED Display Function

The ‘displayReadings’ function updates an OLED display with PM1, PM2.5, CO,

SO2, and AQI readings. It starts by clearing the display and setting text size to small with

white color. Each parameter (pm1, pm2, co, so2, aqi) is displayed with its respective unit

(ug/m3 for PM1 and PM2.5, ppm for CO and SO2, and no unit for AQI). After printing all

values, the display is updated, and a 5-second delay is added to maintain visibility. This

function efficiently presents air quality data on the OLED screen.

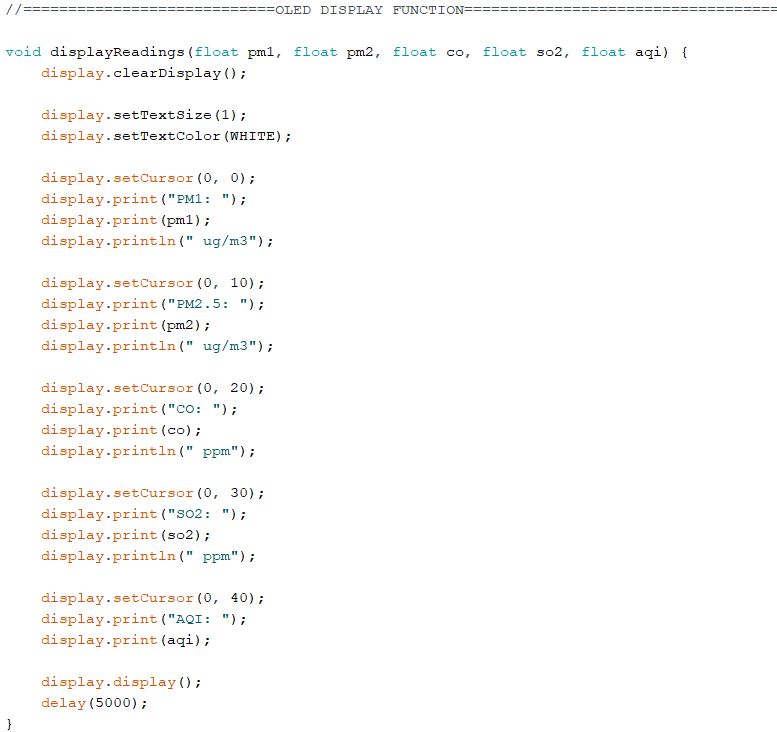
[picture p46: figure]

43

Figure 40: OLED display function definition

### 5.1.10 Function for sending sensor data to cloud

The ‘sendSensor’ function sends sensor data to Blynk Cloud using virtual pins: PM1

(‘pm1_d’) to V0, PM2.5 (‘pm25_d’) to V1, CO (‘co_d’) to V2, SO2 (‘so_d’) to V3, and AQI

(‘aqi_d’) to V4, each followed by a 2-second delay between subsequent transmissions. It logs

each transmission with a message to the Serial monitor confirming data sent to Blynk Cloud,

ensuring continuous updates for real-time air quality monitoring and analysis.

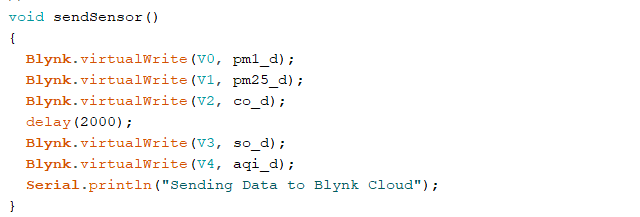
[picture p47: figure]

44

Figure 41: Function for sending data to Cloud

### 5.1.11 VoidSetup ()

The ‘setup’ function initializes the ESP microcontroller and sets up necessary

configurations for operation. It begins by initializing serial communication at a baud rate of

115200. If the OLED display fails to initialize with the SSD1306 driver, an error message is

printed, and the program halts. Following successful initialization, it clears the display

buffer. Depending on the ‘bootCount’, it either executes initialization routines or enters a

regular operation mode. During initialization (‘bootCount == 0’), it calculates PM1

(‘concentration1’) and PM2.5 (‘concentration2’) values, CO (‘tempCO’), and SO2

(‘tempSO’). It displays these values on the OLED screen using ‘displayReadings’ and

enqueues them into respective circular queues (‘pm1Arr’, ‘pm25Arr’, ‘coArr’, ‘soArr’) while

printing the enqueued values to Serial. Upon subsequent runs (‘bootCount > 0’), it repeats

these operations, increments ‘runcount’, and calculates hourly AQI based on historical data

in the circular queues. It updates the OLED display with the calculated AQI and prepares

data (‘pm1_d’, ‘pm25_d’, ‘co_d’, ‘so_d’, ‘aqi_d’) for transmission to Blynk Cloud. Finally,

it sets the ESP to sleep mode, waking up periodically for measurements and data

transmission.

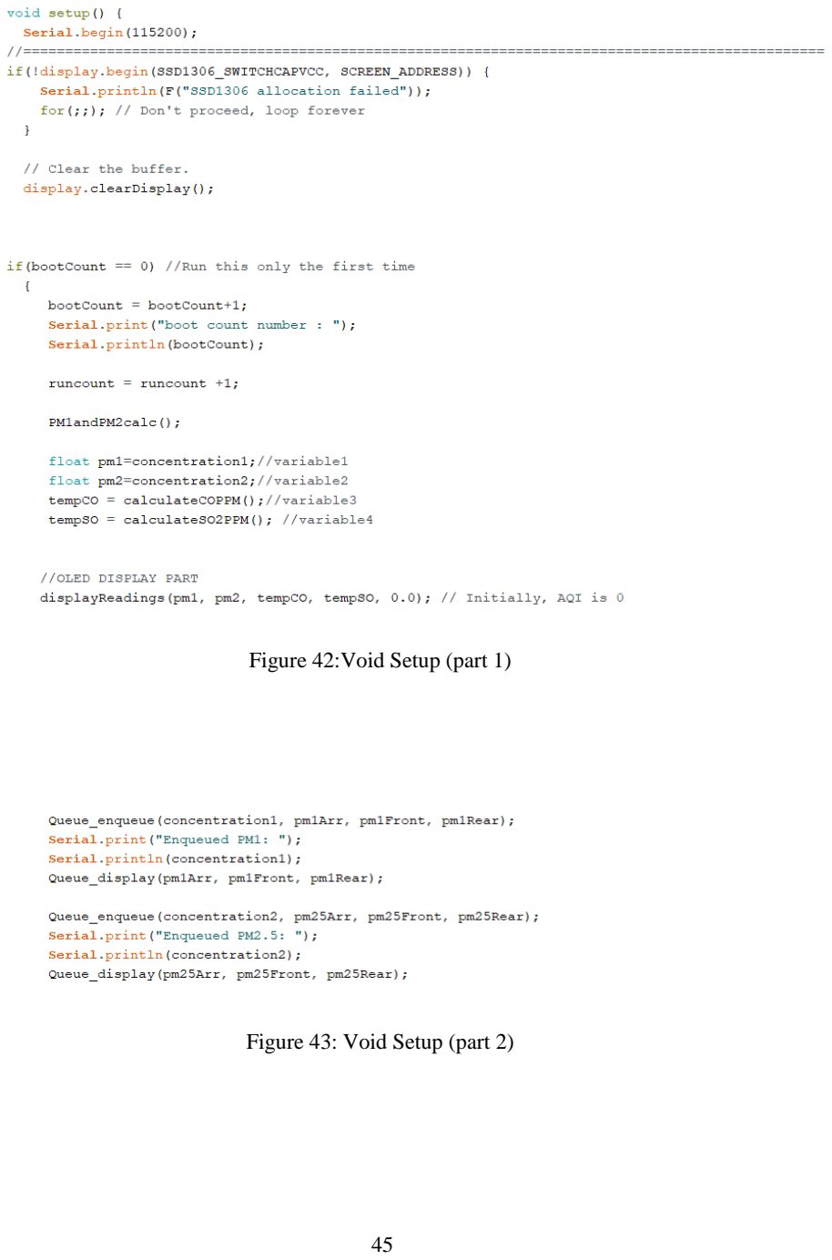
[picture p48: page 65]

45

Figure 42:Void Setup (part 1)

Figure 43: Void Setup (part 2)

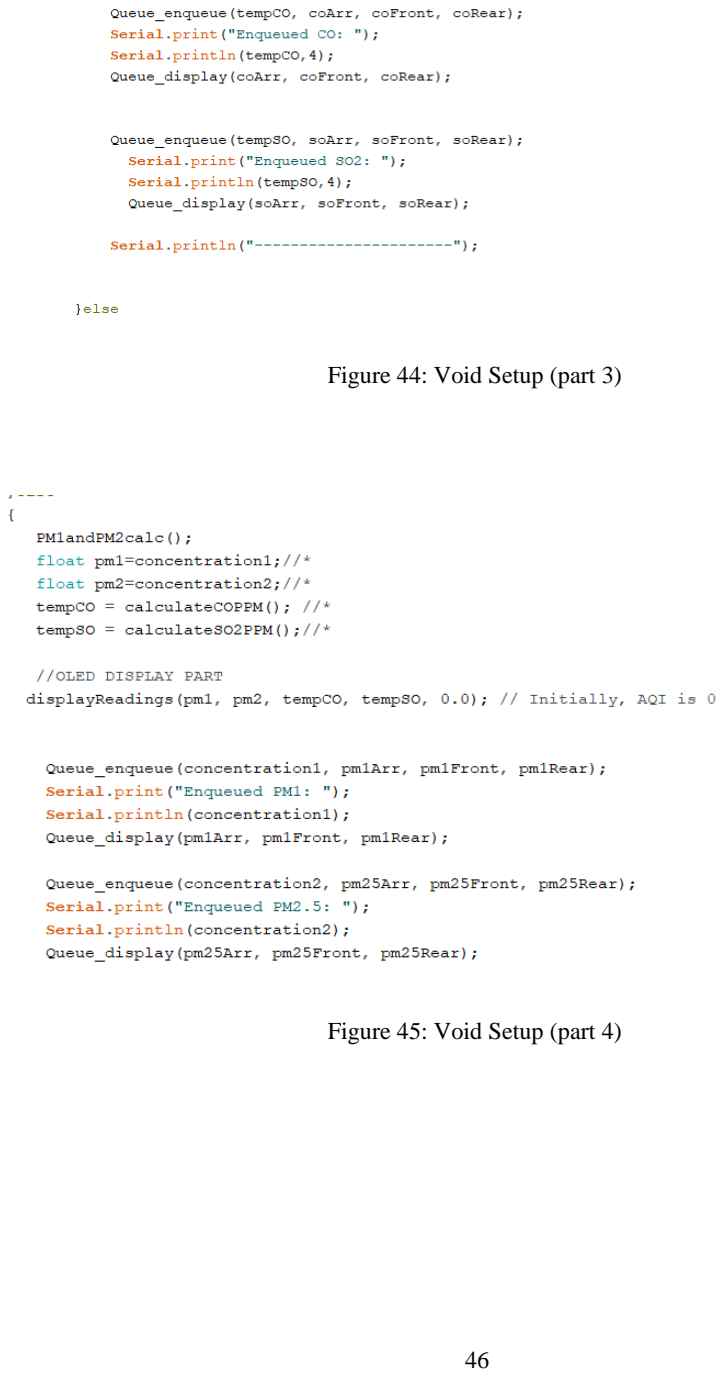
[picture p49: page 66]

46

Figure 44: Void Setup (part 3)

Figure 45: Void Setup (part 4)

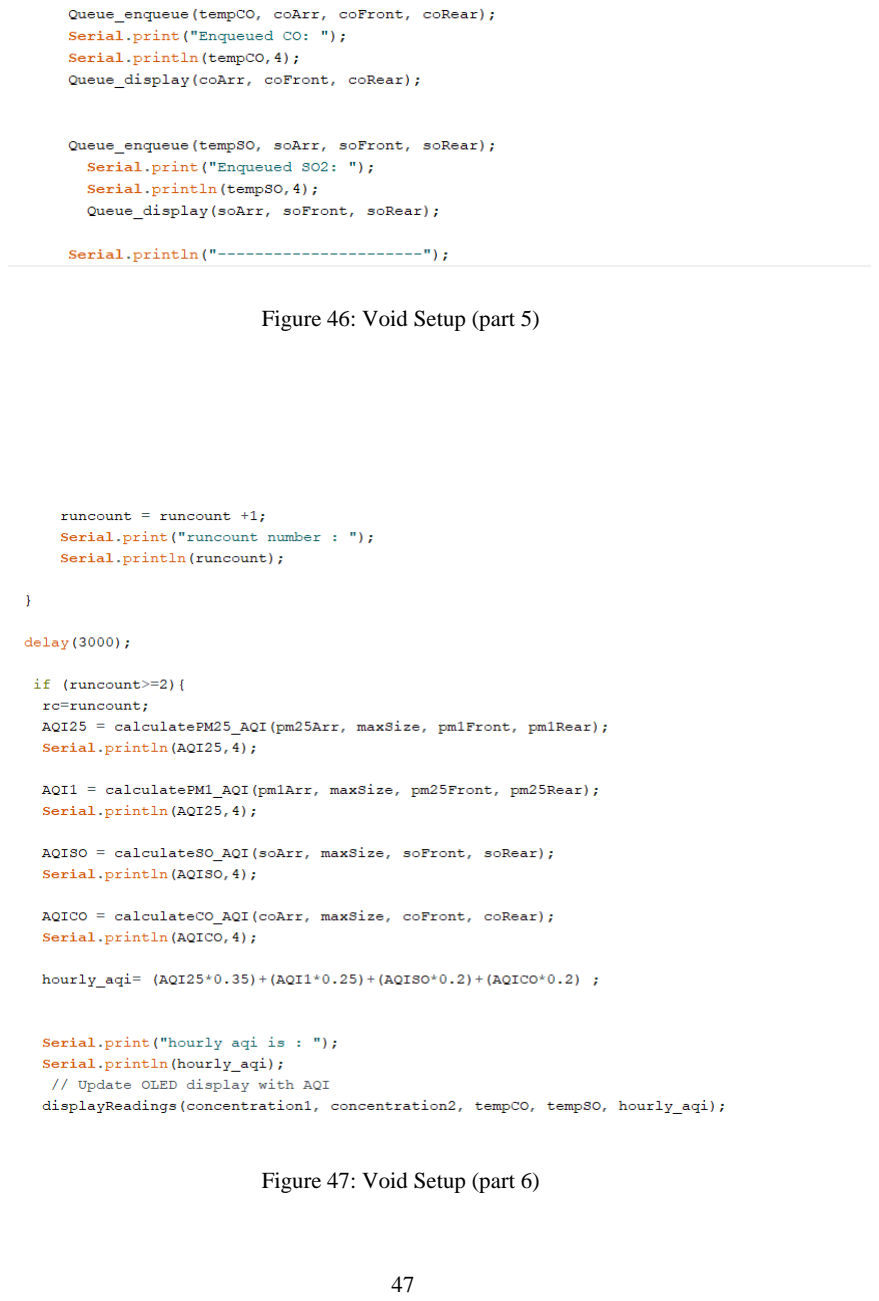
[picture p50: page 67]

47

Figure 46: Void Setup (part 5)

Figure 47: Void Setup (part 6)

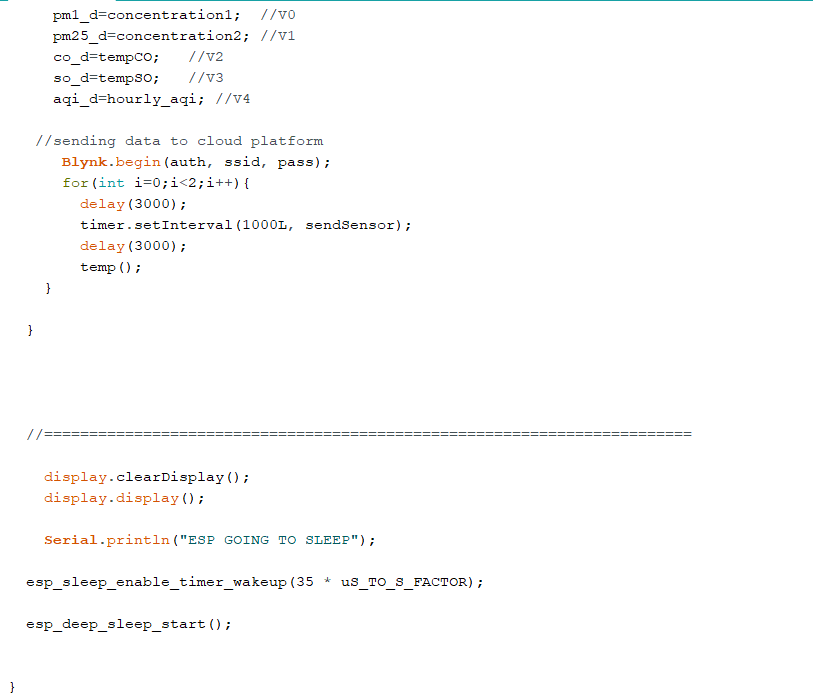
[picture p51: figure]

48

Figure 48: Void Setup (part 7)

### 5.1.12 Blynk.run function for delay

This function is defined to provide a certain execution time for the ‘Blynk.run’ and

‘timer.run’ commands. This function when called in setup provides enough delay time for

complete transfer of data to Blynk’s Cloud platform.

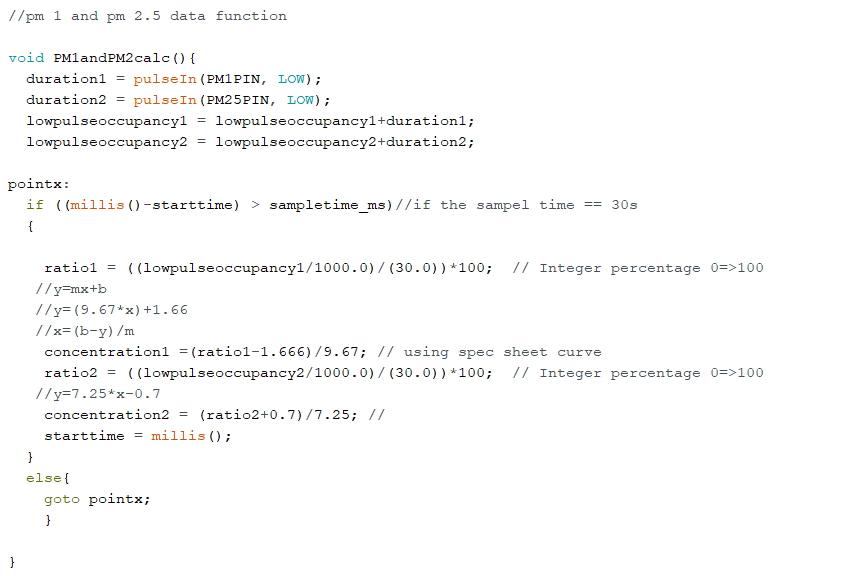
[picture p52: figure]

49

Figure 49: Execution time function for Blynk.run() command

### 5.1.13 PM1 and PM2.5 data function

The `PM1andPM2calc` function measures durations of low pulses from PM1 and

PM2.5 sensors, accumulates these in `lowpulseoccupancy1` and `lowpulseoccupancy2`,

respectively, and calculates occupancy ratios over a 30-second sample period. Using

predefined conversion curves from sensor specifications, it computes concentrations for PM1

(`concentration1`) and PM2.5 (`concentration2`). The function loops until the sample time

ends, ensuring continuous monitoring and calculation of particulate concentrations.

Figure 50: PM1 and PM2.5 data function

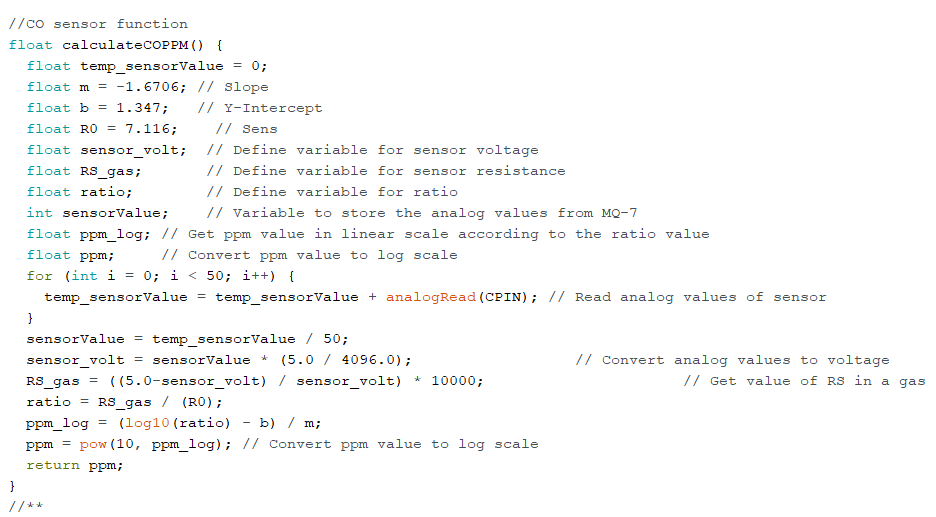
[picture p53: figure]

50

### 5.1.14 CO sensor ppm function

The ‘calculateCOPPM’ function reads analog values from a CO sensor (MQ-7)

through multiple samples, computes the average, and converts these values into voltage. It

then calculates the sensor resistance (RS_gas) based on the voltage, compares it to a

reference resistance (R0), and derives a ratio. Using predefined slope (m) and y-intercept (b)

values specific to the sensor's calibration curve, it converts the ratio into a logarithmic scale

representing CO concentration in parts per million (ppm). The function returns this ppm

value, providing a measure of CO concentration detected by the sensor.

Figure 51: CO concentration (ppm) function

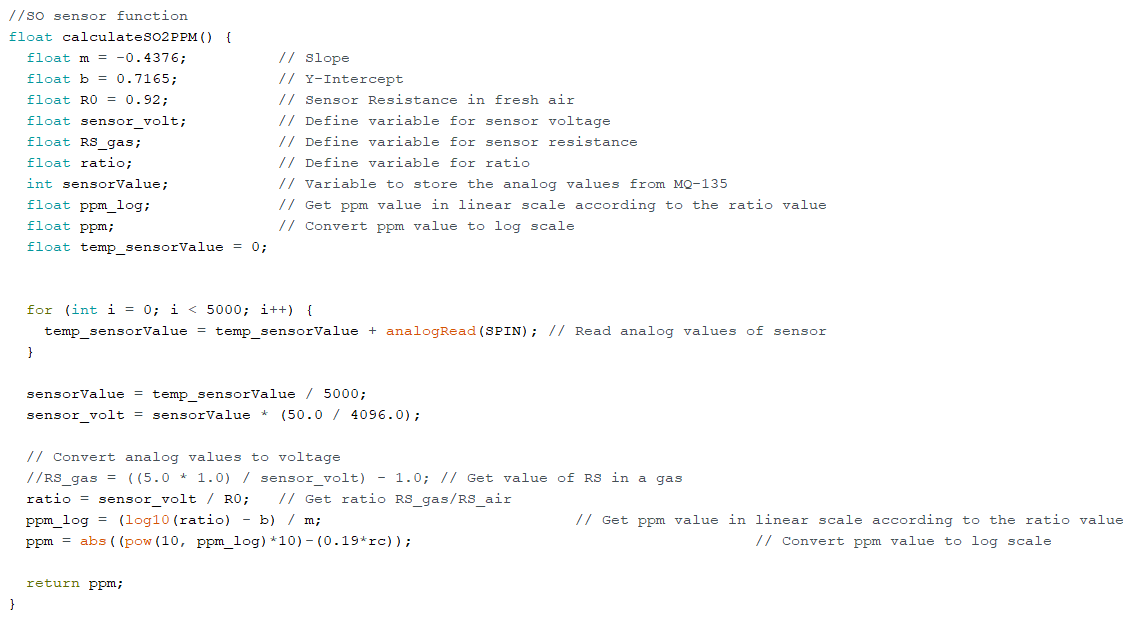
[picture p54: figure]

51

### 5.1.15 SO2 sensor ppm Function

The `calculateSO2PPM` function reads analog values from an SO2 sensor (MQ-135)

over several samples to compute an average. It converts these values into voltage and

calculates the sensor resistance (RS_gas). By comparing this resistance to a reference

resistance (R0), it determines a ratio representing the concentration of SO2 in the air. Using

predefined slope (m) and y-intercept (b) values specific to the sensor's calibration curve, it

converts this ratio into a logarithmic scale representing SO2 concentration in parts per

million (ppm).

Figure 52: SO2 concentration ppm function

### 5.1.16 Air Quality standard mapping conditions

The `printAirQualityDescription` function interprets the Air Quality Index (AQI) to

provide concise descriptions of current air conditions. It categorizes AQI values into several

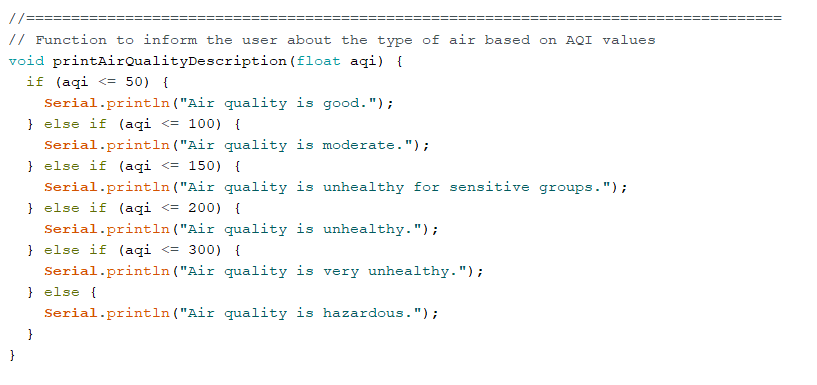
[picture p55: figure]

52

levels: "good" (0-50), "moderate" (51-100), "unhealthy for sensitive groups" (101-150),

"unhealthy" (151-200), "very unhealthy" (201-300), and "hazardous" (300+). Each category

corresponds to escalating levels of health concern, guiding users on the potential impacts of

air quality on their well-being based on recognized standards.

Figure 53: AQI mapping function

### 5.1.17 AQI calculator function for PM2.5

The ‘calculatePM25_AQI’ function computes the Air Quality Index (AQI) for PM2.5

concentrations using data stored in the array ‘arr’. It calculates the PM2.5 concentration

(‘pm25Concentration’) through a weighted average and assigns an AQI based on predefined

breakpoints. The function categorizes PM2.5 levels into six AQI ranges and computes the

AQI using a linear formula derived from these breakpoints. This numerical assessment is

essential for monitoring PM2.5 pollution levels and understanding their potential health

impacts.

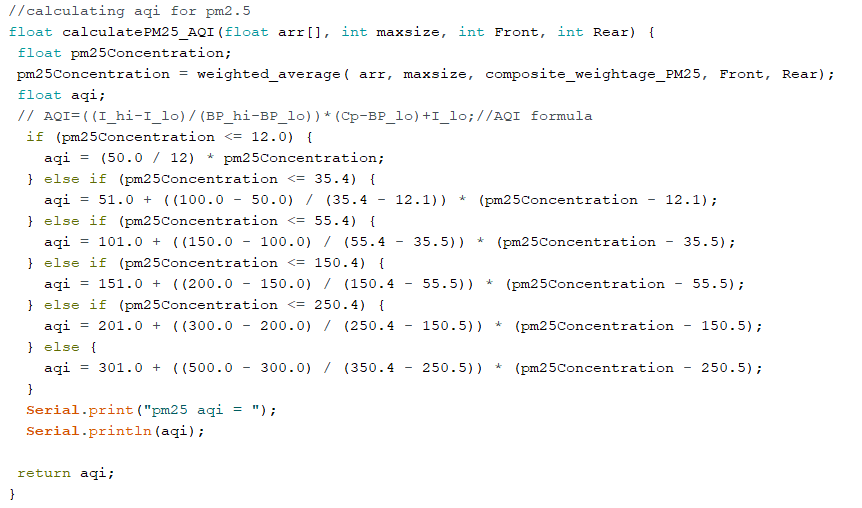
[picture p56: figure]

53

Figure 54: PM 2.5’s AQI calculator function

### 5.1.18 AQI Calculator Function for PM1

The ‘calculatePM1_AQI’ function calculates the Air Quality Index (AQI) for PM1

concentrations using data stored in the array ‘arr’. It computes the PM1 concentration

(‘pm1Concentration’) by taking a weighted average from the array. The function then

determines the appropriate AQI category based on predefined breakpoints for PM1 levels. It

assigns an AQI value using a linear interpolation formula derived from these breakpoints,

ensuring that the AQI reflects the severity of PM1 pollution accurately

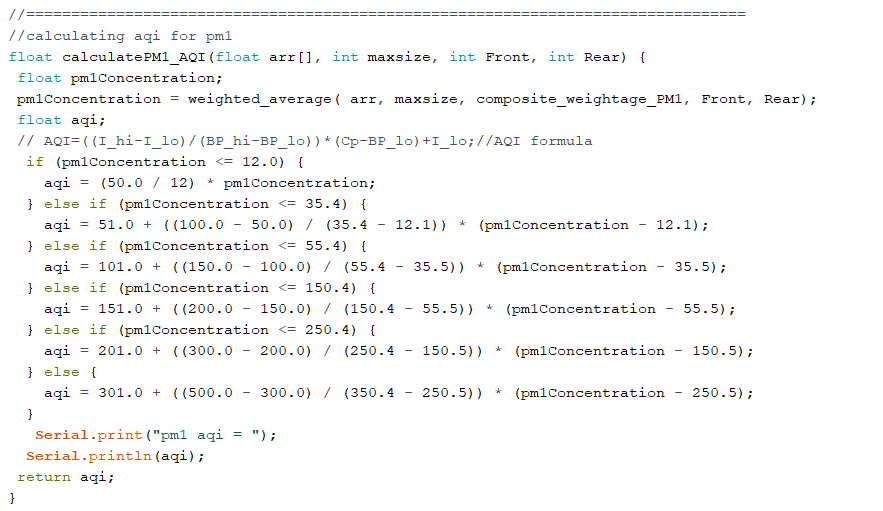
[picture p57: figure]

54

Figure 55: PM1’s AQI calculator function

### 5.1.19 AQI Calculator function for CO

The `calculateCO_AQI` function calculates the Air Quality Index (AQI) for carbon

monoxide (CO) based on a weighted average from the `arr` array. It evaluates the CO

concentration (`coConcentration`) and assigns an AQI value using predefined thresholds.

These thresholds categorize CO levels into various AQI ranges using linear interpolation,

providing a precise indication of CO pollution severity.

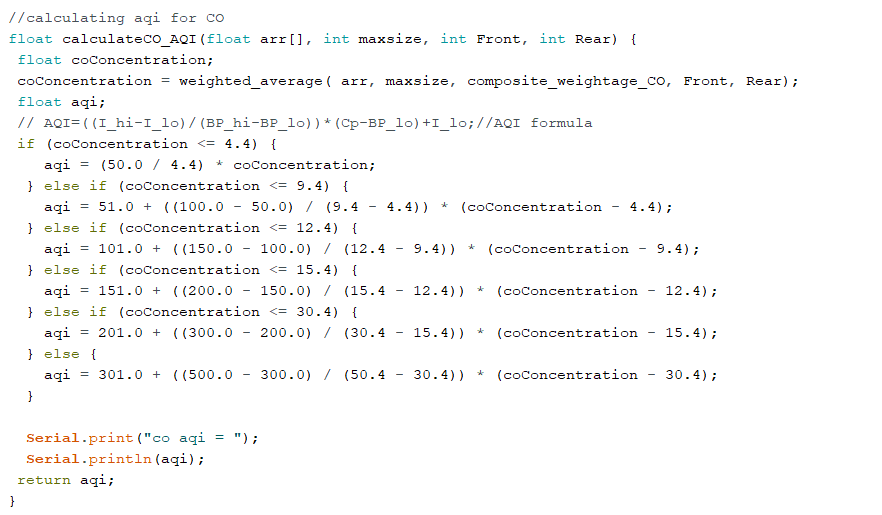
[picture p58: figure]

55

Figure 56: CO's AQI calculator function

### 5.1.20 AQI calculator for SO2

The ‘calculateSO_AQI’ function determines the Air Quality Index (AQI) for sulfur

dioxide (SO2) by averaging concentrations from ‘arr’. It applies breakpoints to categorize

SO2 levels into AQI ranges via linear interpolation, producing an ‘aqi’ value that assesses

pollution levels and informs measures to address air quality concerns. This function plays a

crucial role in evaluating SO2 contamination and guiding strategies to mitigate its

environmental and health effects.

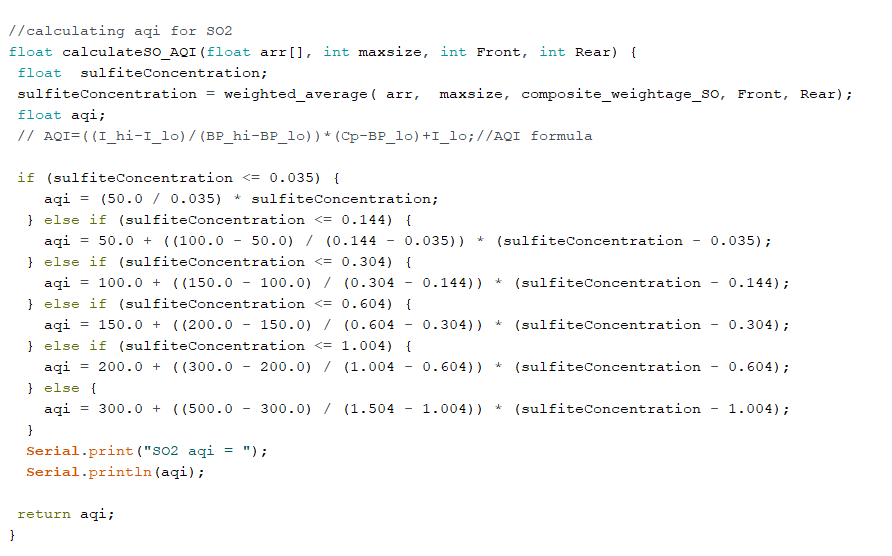
[picture p59: figure]

56

Figure 57: SO2 's AQI calculator function

### 5.1.21 Weighted Average Calculator Function

The ‘weighted_average’ function calculates an average where recent data has more

impact than older data. It uses a technique where each data point is multiplied by a

decreasing power of 2, meaning newer data points contribute more to the average than older

ones. This helps in reflecting current trends or conditions based on the sequence of data

received. The function computes the weighted sum of values and divides it by the sum of the

weights to produce a weighted average result, which is useful for applications like

monitoring changes over time.

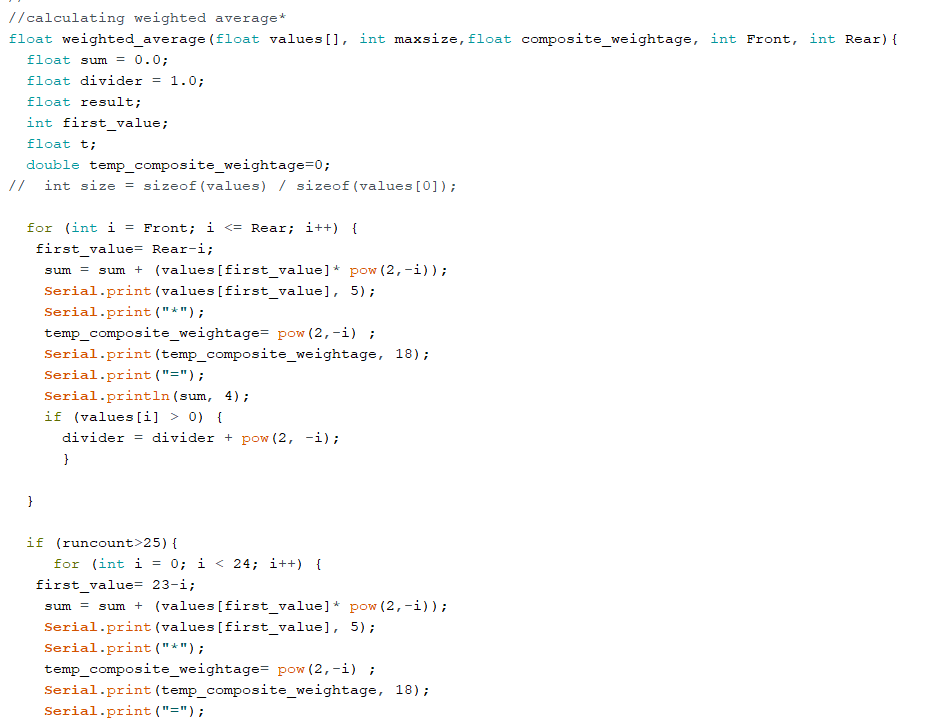
[picture p60: figure]

57

Figure 58: Weighted Average function (part 1)

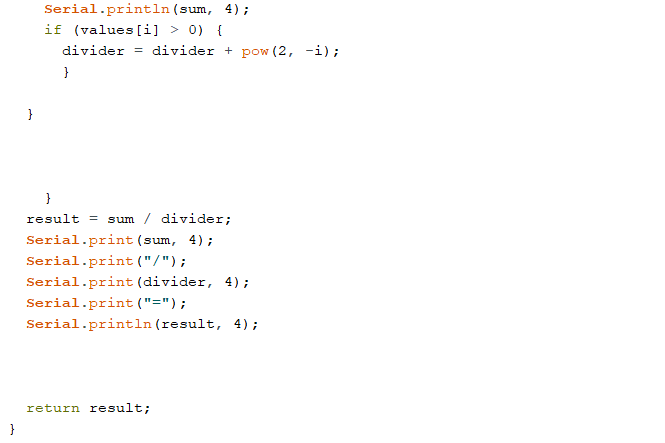
[picture p61: figure]

58

Figure 59: Weighted Average function (part 2)

### 5.2 Predictive analysis:

### 5.2.1 Data visualization:

Our first step was to read dataset form excel file and view it in our chosen

environment which was python jupyter notebook

Figure 60: Data visualization code (part 1)

The code reads the dataset into a DataFrame using the pandas library and then prints

the first and last few rows to give a snapshot of the data.

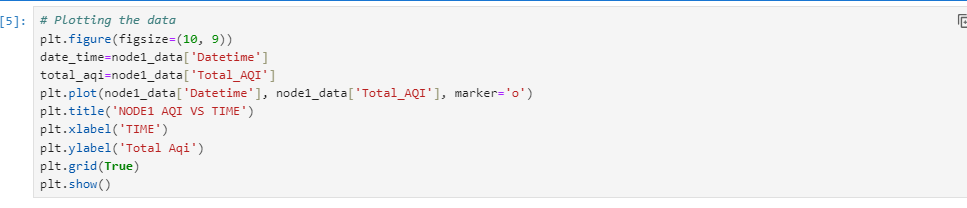
[picture p62: figure]

59

Figure 61: Data Visualization code (part 2)

The code is then used to display the structure and data types of the columns in the

dataset. By using the info() method on the DataFrame, we can obtain a concise summary that

includes the number of non-null entries in each column, the data type of each column, and

the memory usage of the DataFrame.

Figure 62: Data visualization code (part 3)

We then visualize the Air Quality Index (AQI) data over time for Node1. By plotting

the Datetime against Total_AQI, we can observe how AQI values change over the recorded

period.

### 5.2.2 Data Correlation:

Figure 63: Data correlation code

The purpose of this code is to analyze and visualize the correlations between various

air quality parameters and the Total AQI. This helps in understanding the relationships

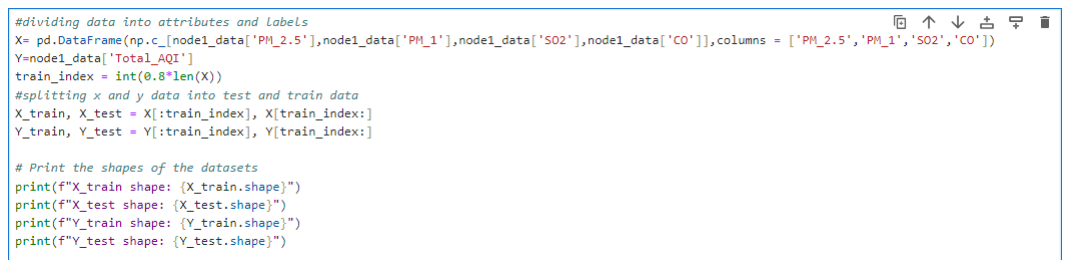
[picture p63: figure]

60

between different pollutants and their combined effect on the air quality. The Kendall

correlation method is used to compute the correlation matrix, which measures the strength

and direction of the association between pairs of variables.

5.2.3 Data Splitting;

Figure 64: Code to split dataset

This code is to prepare the dataset for training and testing machine learning models. It

involves dividing the data into attributes (features) and labels (target), and then splitting this

data into training and testing sets. The attributes are defined by creating a DataFrame X

containing the columns PM_2.5, PM_1, SO2, and CO. The labels (target) are defined as the

Total_AQI column from the dataset, forming YResults explanation.

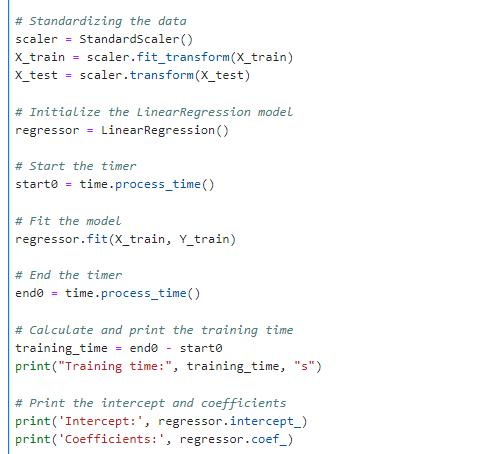
[picture p64: figure]

61

### 5.2.4 Linear Regression:

Figure 65: Linear Regression code

First, it standardizes the training and testing data using StandardScaler to ensure that

all features have a mean of zero and a standard deviation of one. The LinearRegression

model is then initialized and trained on the standardized training data.

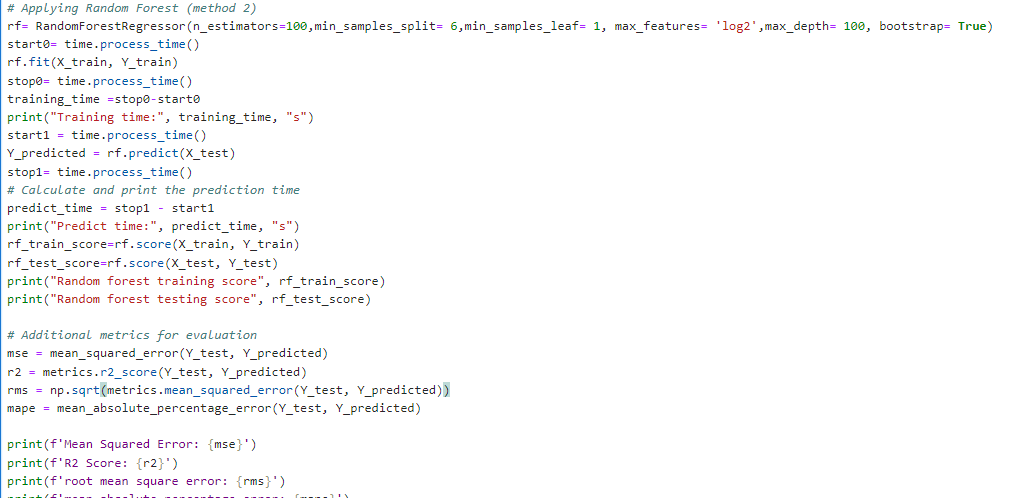
[picture p65: figure]

62

### 5.2.5 Random Forest model:

Figure 66: Random Forest Model code

The regressor (rf) is initialized with 100 estimators (n_estimators), a minimum of 6

samples required to split an internal node (min_samples_split), 1 sample required to be at a

leaf node (min_samples_leaf), 'log2' as the maximum number of features considered for

splitting (max_features), a maximum depth of 100 for each tree (max_depth), and uses

bootstrapped samples (bootstrap=True). It measures training and prediction times using

time.process_time() to evaluate computational efficiency. After training on X_train and

Y_train, it predicts outcomes for X_test and computes training and testing scores

(rf_train_score, rf_test_score) to assess model performance. This approach ensures that the

Random Forest model is effectively tuned and evaluated based on its configured

hyperparameters and computational performance.

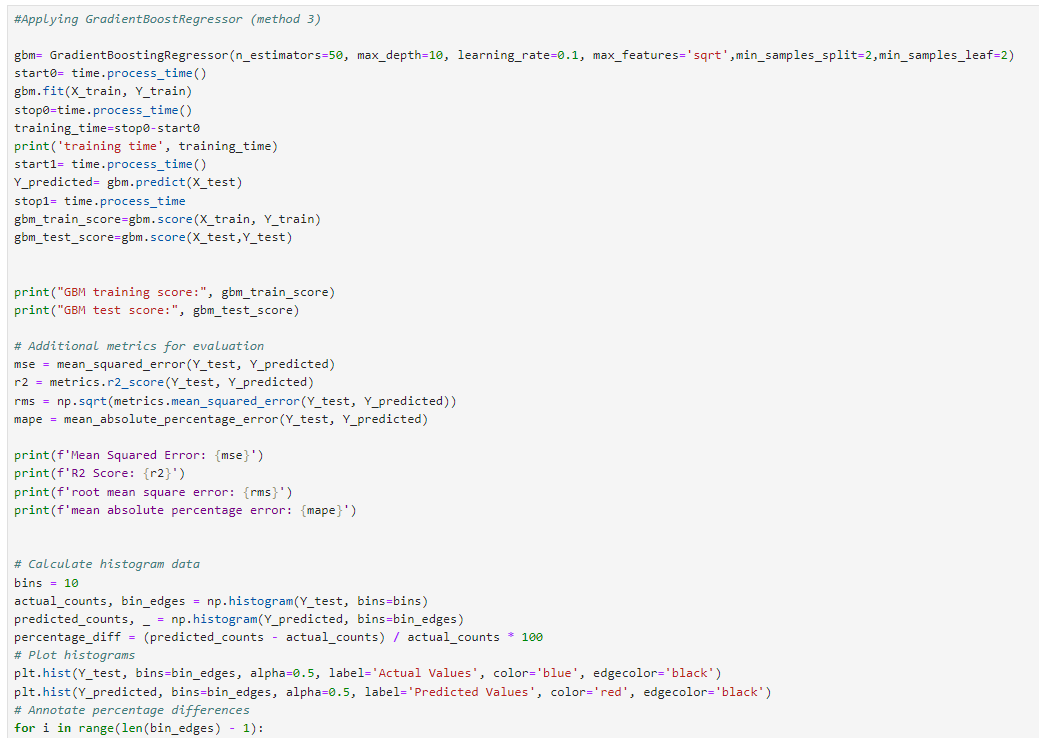
[picture p66: figure]

63

### 5.2.6 Gradient Boost Regressor:

Figure 67: Gradient Boost Regressor code

The above code snippet initializes a GradientBoostingRegressor using Python's

scikit-learn library with the following hyperparameters: 50 estimators (n_estimators),

maximum depth of 10 for each tree (max_depth), learning rate of 0.1 (learning_rate), 'sqrt' as

the maximum number of features considered for splitting (max_features), minimum of 2

samples required to split an internal node (min_samples_split), and 2 samples required to be

at a leaf node (min_samples_leaf).

It then measures the training time using time.process_time() before and after fitting

the model (gbm.fit(X_train, Y_train)), providing insights into computational efficiency.

After training, it predicts outcomes for X_test using gbm.predict(X_test) and calculates

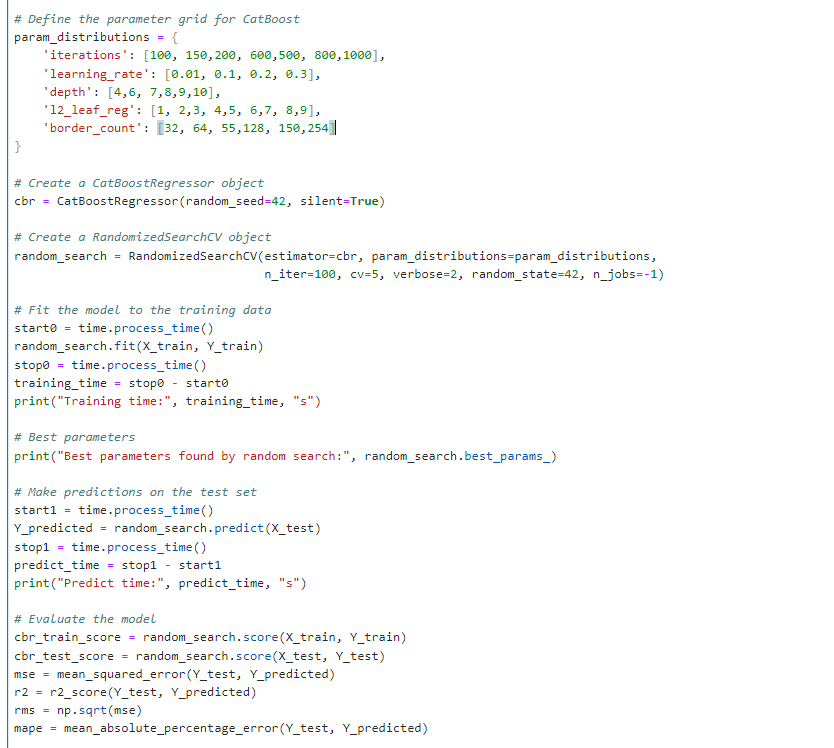
[picture p67: figure]

64

training and testing scores (gbm_train_score, gbm_test_score) using gbm.score() to evaluate

model performance on both training and testing datasets (X_train, Y_train, X_test, Y_test).

This method allows for the optimization and evaluation of the Gradient Boosting

Regressor based on its specified hyperparameters

### 5.2.7 CAT Boost Regressor:

Figure 68: CAT Boost Regressor Model code

The code defines a parameter grid (param_distributions) encompassing key

hyperparameters such as iterations, learning rate, tree depth, L2 regularization, and border

65

count. A CatBoostRegressor instance (cbr) is initialized with a fixed random seed and

silenced output to facilitate stable and quiet training. Employing RandomizedSearchCV, the

code conducts a randomized search cross-validation to explore 100 different combinations

(n_iter=100) across 5 folds (cv=5), leveraging parallel computing for efficiency (n_jobs=-1).

The model is then trained on the provided training dataset (X_train, Y_train), and the best-

performing hyperparameters identified by the search are reported. Subsequently, predictions

are generated for the test dataset (X_test), and performance metrics such as training and

testing scores (cbr_train_score, cbr_test_score), mean squared error (mse), R-squared (r2),

and root mean squared error (rms) are computed to assess model accuracy and robustness.

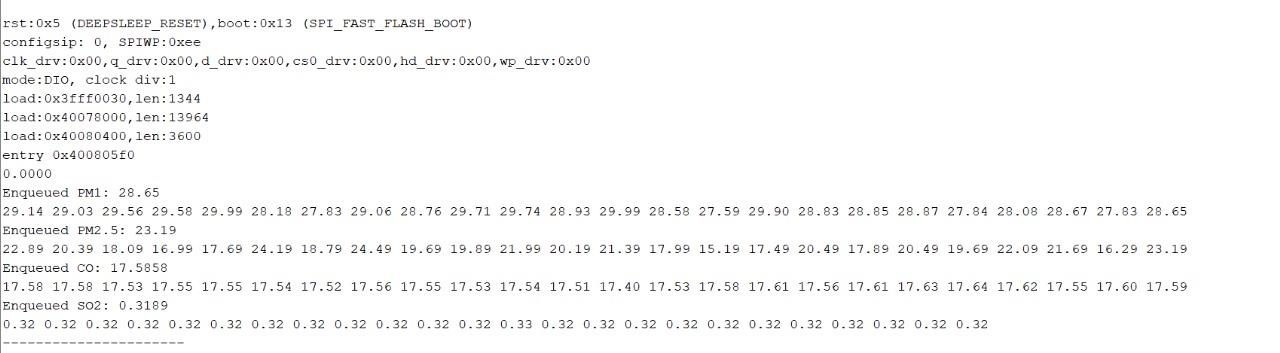
[picture p68: figure]
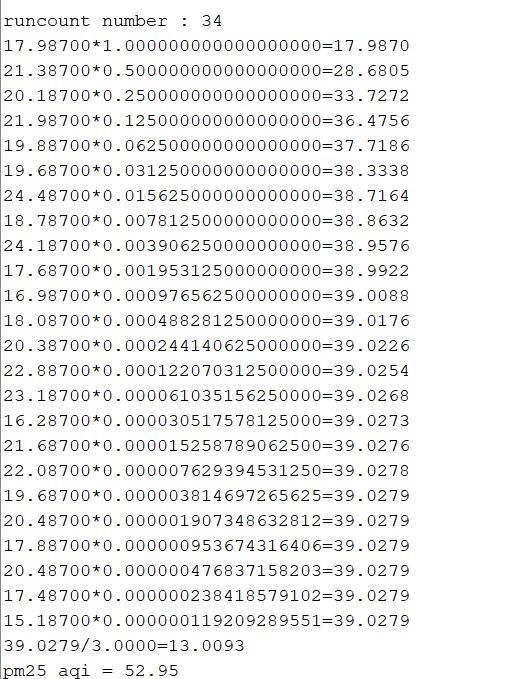
[picture p69: figure]

66

### 6 CHAPTER 05: RESULTS

### 6.1 Arduino Serial Monitor

The first display observed on the serial Monitor is the RTC deep sleep reset and its

clock parameters. The numerically queued values are the enqueued sampled value of all four

pollutants (PM2.5, PM1, CO, SO2).

Figure 69: Serial Monitor display (part 1)

Figure 70: Serial Monitor display (part 2)

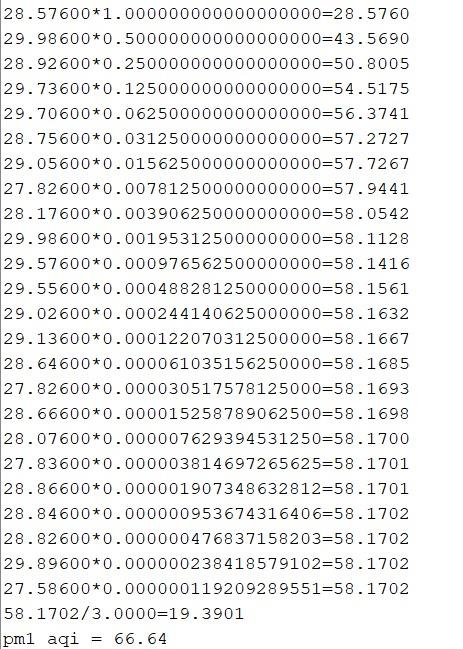
[picture p70: figure]
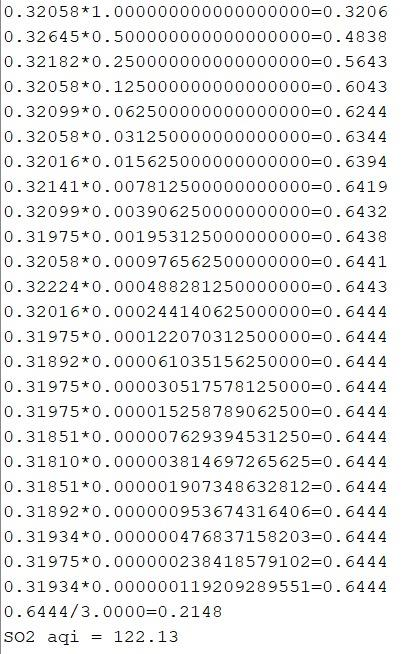
[picture p71: figure]

67

Figure 71: Serial Monitor display (part 3)

Figure 72: Serial Monitor display (part 4)

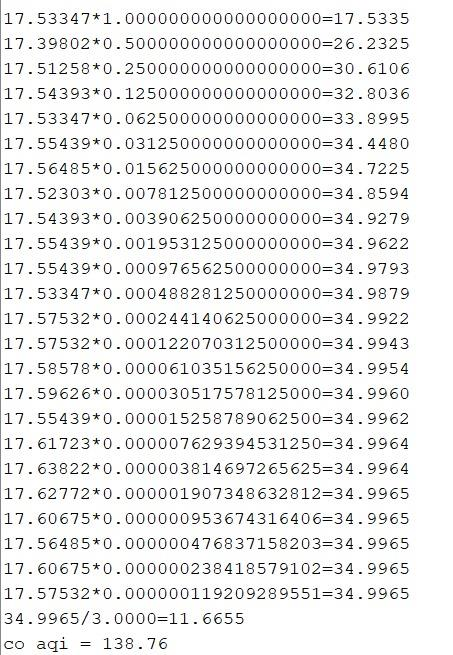
[picture p72: figure]

68

Figure 73: Serial Monitor display (part 5)

The Final AQI is displayed on the serial Monitor after the display of the individual

AQIs of each pollutant. ESP32 then connects with the Wi-Fi connection with the SSID and

Password defined in the code which is validated when the IP address of that Wi-Fi

connection is displayed on the serial Monitor. Following this, ESP32 sends data to cloud and

the message “Sending data to Blynk Cloud” validates the successful data transfer to cloud.

Finally, the ESP32 goes into deep sleep mode for the next hour which is also observed on the

serial monitor.

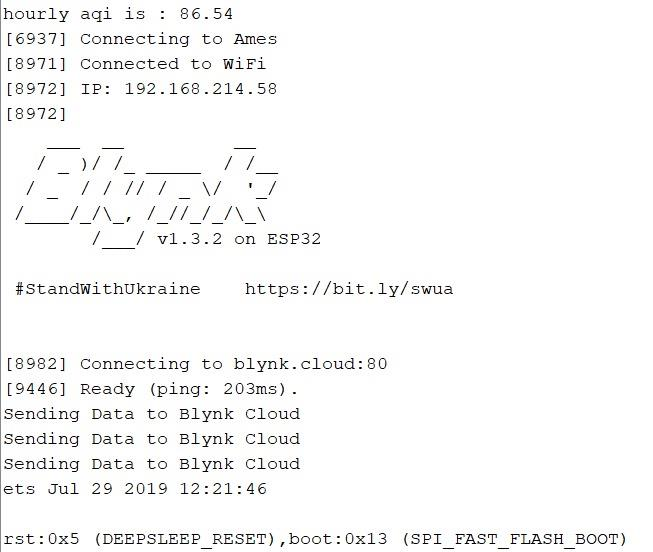
[picture p73: figure]

69

Figure 74: Serial Monitor display (part 6)

### 6.2 Cloud Display Results

Separate Cloud Templates are created for each node to display individual pollutant

concentrations and the Final AQI which can be remotely viewed by the users. Live changes

in pollutants’ concentration and overall AQI can be observed anytime.

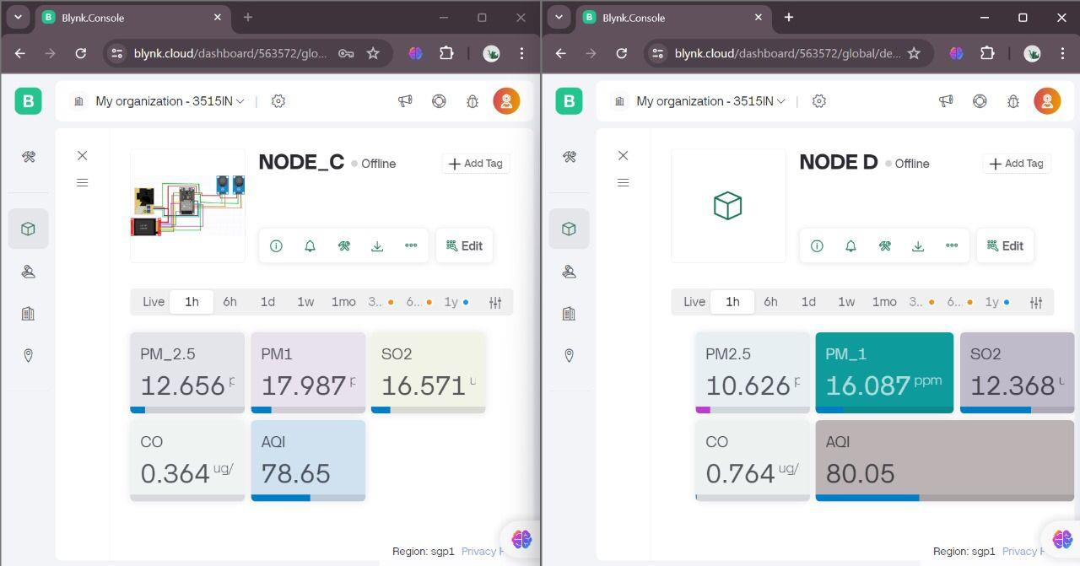
[picture p74: figure]
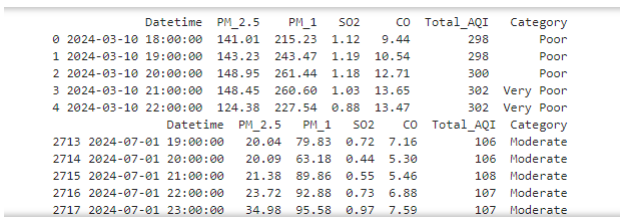
[picture p75: figure]

70

Figure 75: Cloud data visualization in templates

### 6.3 Predictive Analysis:

### 6.3.1 Data visualization:

Figure 76: Data Visualization (part 1)

The output shows a segment of the dataset, which includes the columns for Datetime,

PM_2.5, PM_1, SO2, CO, Total_AQI, and Category. The Datetime column represents the

timestamp for each data point, while the other columns represent the concentrations of

different pollutants and the overall Air Quality Index (AQI). The Category column classifies

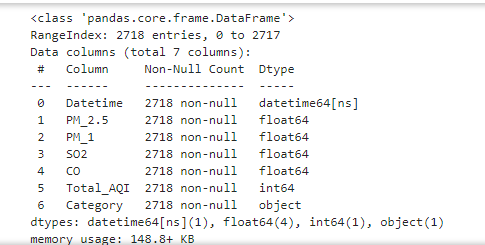
[picture p76: figure]

71

the air quality into different levels such as "Poor," "Very Poor," and "Moderate." This initial

inspection helps to understand the structure of the data and to verify that the data has been

loaded correctly.

Figure 77: Data visualization results (part 2)

The output shows that the dataset contains 2718 entries and 7 columns: Datetime,

PM_2.5, PM_1, SO2, CO, Total_AQI, and Category. Each column has 2718 non-null entries,

indicating there are no missing values. The data types for the columns are as follows:

Datetime is of type datetime64[ns], PM_2.5, PM_1, SO2, and CO are float64, Total_AQI is

int64, and Category is object.

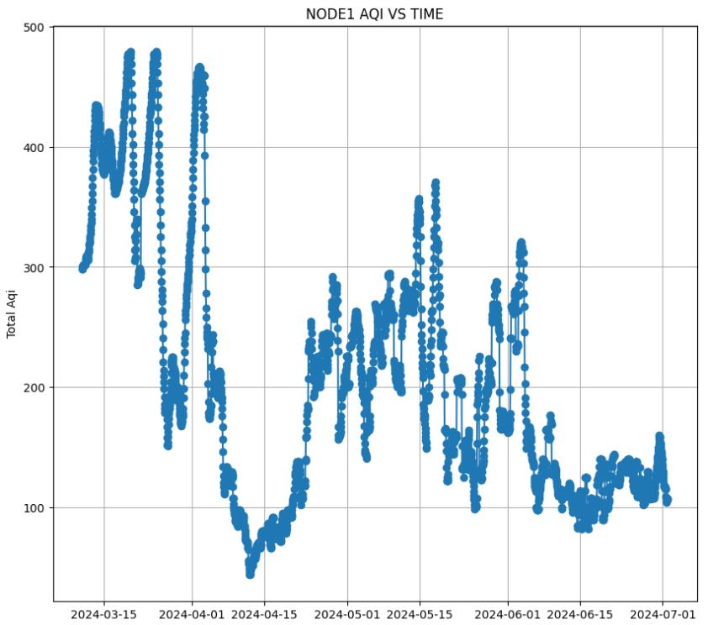
[picture p77: figure]

72

Figure 78: Data visualization results (part 3)

The output graph titled "NODE1 AQI VS TIME" shows the Total_AQI values

plotted against the Datetime. The x-axis represents the time, while the y-axis represents the

Total AQI. We can see an overall deceasing trend in AQI from the staring month of March

till the last month of July. This observation aligns with monthly AQI trends of Pakistan.


73

### 6.3.2 Data Correlation:

Figure 79: correlation heatmap results

The diagonal from top left to bottom right represents the correlation of each variable

with itself. As expected, these values are all 1 (perfect positive correlation). Off-diagonal

correlations reveal interesting insights. PM_2.5 and PM_1 exhibit a strong positive

correlation (0.82), indicating that as particulate matter concentrations increase, both

indicators move together. Total_AQI also correlates well with PM_2.5 (0.76) and PM_1

(0.77). However, carbon monoxide (CO) shows weak positive correlations with other

variables (ranging from 0.046 to 0.27)

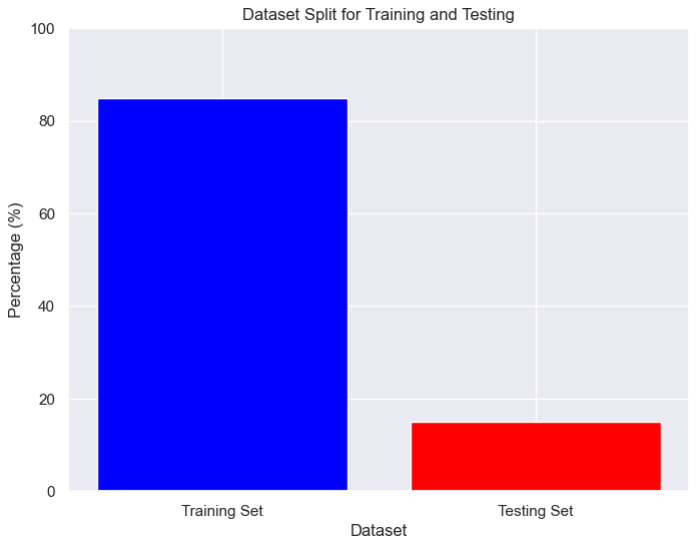
[picture p78: figure]

74

### 6.3.3 Data splitting:

Figure 80: Data Split results

The data is split into training and testing sets. The train_index is calculated to split the data

such that 80% is used for training and 20% for testing.

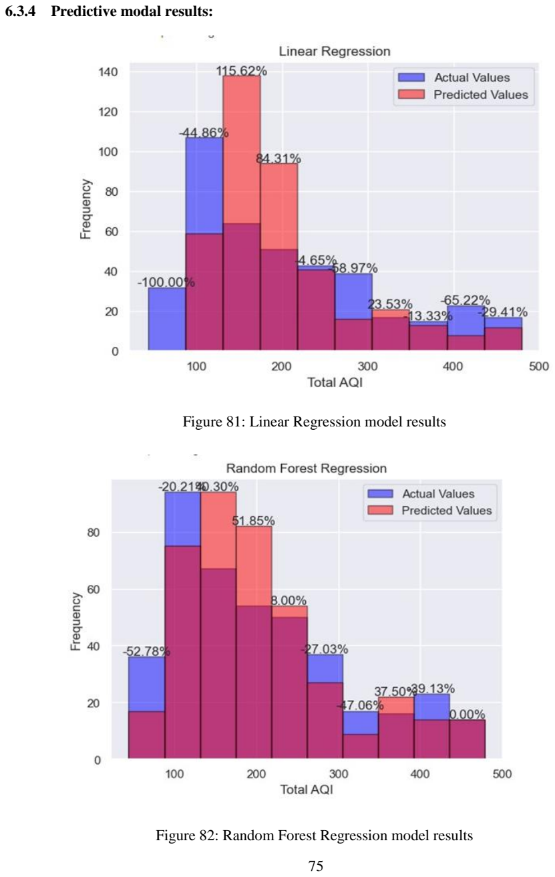
[picture p79: page 95]

75

### 6.3.4 Predictive modal results:

Figure 81: Linear Regression model results

Figure 82: Random Forest Regression model results

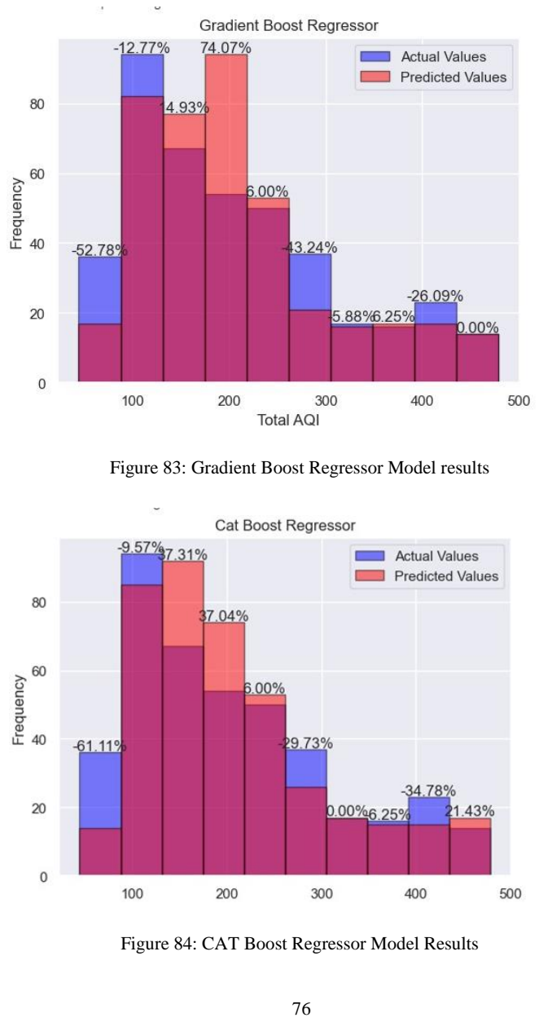
[picture p80: page 96]

76

Figure 83: Gradient Boost Regressor Model results

Figure 84: CAT Boost Regressor Model Results

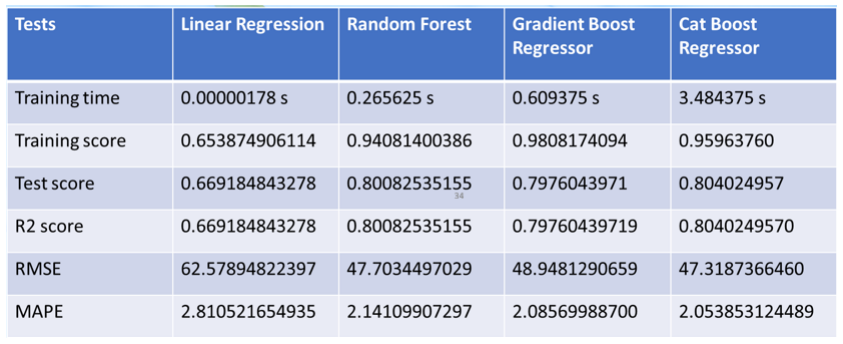
[picture p81: figure]

77

### 6.3.5 Model test score comparisons:

- Linear Regression: Quickest training time but has a moderate performance and

higher errors, indicating it's suitable for simple linear relationships.

- Random Forest: Good balance of training time and performance with low errors,

suitable for more complex datasets.

- Gradient Boost Regressor: High accuracy but longer training time, suitable for high

predictive performance needs.

- CatBoost Regressor: High performance with efficient handling of categorical

features but longer training time.

78

### 7 CHAPTER 06

### 7.1 UN-SDGs mapping

Initiating a comprehensive approach to sustainable development, this project aligns

closely with four key Sustainable Development Goals (SDGs):

### 7.1.1 Goal 3: Good Health and Well-being

Through continuous monitoring of air quality and real-time data on pollutants, the

project promotes improved health and well-being. Access to precise air quality information

empowers individuals and communities to proactively safeguard their health against the

adverse effects of air pollution.

### 7.1.2 Goal 11: Sustainable Cities and Communities

Enhancing urban environmental quality through the monitoring of atmospheric

parameters and air quality index (AQI), the project supports sustainable urban development.

The data provided enables informed decision-making aimed at enhancing living conditions in

cities, such as Islamabad.

### 7.1.3 Goal 13: Climate Action

The project contributes directly to climate action by monitoring and mitigating air

pollution. Understanding pollutant levels and their sources helps stakeholders develop

strategies to reduce emissions and mitigate environmental impacts, thereby supporting global

efforts to combat climate change.

### 7.1.4 Goal 17: Partnerships for the Goals

Collaboration among stakeholders, including government agencies, NGOs, and local

communities, is crucial for the project's success in air quality monitoring. By fostering

79

partnerships for environmental data collection, analysis, and decision-making, the project

promotes collective action towards achieving sustainable development goals.

80

### 8 FUTURE WORK

Looking to the future, this project holds potential for expansion into a larger real-time

network for Air Quality Index (AQI) monitoring. Scaling up would involve deploying

additional nodes to cover a broader geographical area, allowing for comprehensive AQI

assessments across multiple locations simultaneously. The data collected from each node

could then be aggregated and analyzed to derive the AQI for larger regions, enhancing our

understanding of air quality dynamics on a broader scale.

Improvements in the cloud setup would support the handling of large volumes of AQI

data from different locations and seasons. This expanded dataset would enable accurate

comparisons over time and geographic regions, providing valuable insights into air quality

trends and variations. Such comprehensive data analysis could significantly contribute to

environmental awareness and informed decision-making regarding air quality management

in Pakistan, ultimately promoting sustainable development and public health initiatives.

81

### 9 REFERENCES

- Iqair website, https://www.iqair.com/pakistan
- Rawal, R. (2019). Air Quality Monitoring System. International Journal of

Computational Science and Engineering, 9(1), 1-9. Retrieved from Research India

Publications website: http://www.ripublication.com/ijcse19/ijcsev9n1_01.pdf

- Banerjee, A., Sikdar, B., & Roy, S. (2022). IoT Based Air Pollution Monitoring

System. RCC Institute of Information Technology. Retrieved from

https://www.rcciit.org/students_projects/projects/ee/2022/GR3.pdf

- Maltare, N. N., & Vahora, S. (2023). Air Quality Index prediction using machine

learning forAhmedabad city. Government Engineering College. Retrieved from

Science Direct website:

https://www.sciencedirect.com/science/article/pii/S277250812300011X

- Kumar Sai, K. B., Ramasubbareddy, S., & Luhach, A. K. (2019). IOT BASED AIR

QUALITY MONITORING SYSTEM USING MQ135 AND MQ7 WITH

MACHINE LEARNING 20(4):599-606. Retrieved from

https://www.researchgate.net/publication/337780520_IOT_based_Air_Quality

_Monitoring_ System_Using_MQ135_and_MQ7_with_Machine_Learning_Analysis (https://www.researchgate.net/publication/337780520_IOT_based_Air_Quality_Monitoring_%20System_Using_MQ135_and_MQ7_with_Machine_Learning_Analysis)

- Ayele, T. W., & Mehta, R. (2018). Air pollution monitoring and prediction using IoT.

2018 Second International Conference on Inventive Communication and

Computational Technologies (ICICCT). Retrieved from

https://www.researchgate.net/publication/327935576_Air_pollution_monitorin

g_and_prediction_using_IoT (https://www.researchgate.net/publication/327935576_Air_pollution_monitoring_and_prediction_using_IoT)
