amnaahmad43200/cloud-connected-aqi-network/docs/images/model_comparison_table.png

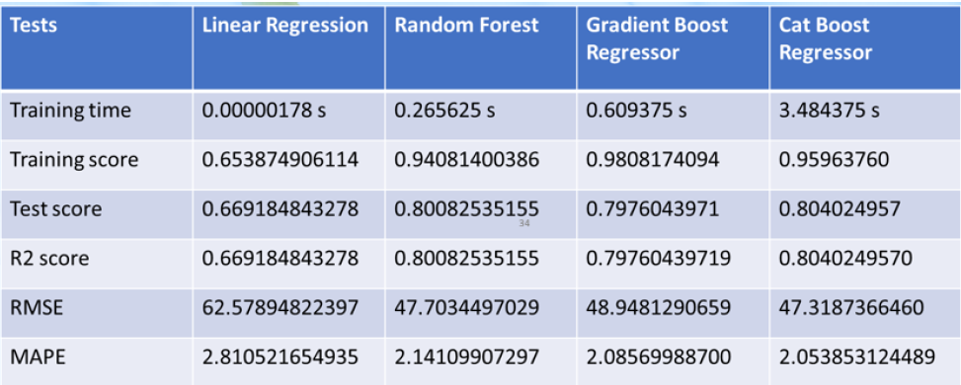
docs/images/model_comparison_table.png
